alancasre133/robotic-startup-automated-arm-worker/HARDWARE.md

# Hardware — Bill of Materials

Everything needed to reproduce the robot car, plus the planned camera and arm
add-ons. Prices are rough estimates (Mexico, 2026, MercadoLibre/Amazon) and will
vary — use them for budgeting, not exact quotes.

## Wiring overview

Wiring overview

If the diagram doesn't render inline, open [docs/wiring-overview.svg](docs/wiring-overview.svg) directly.

## Pi 3 GPIO pinout reference

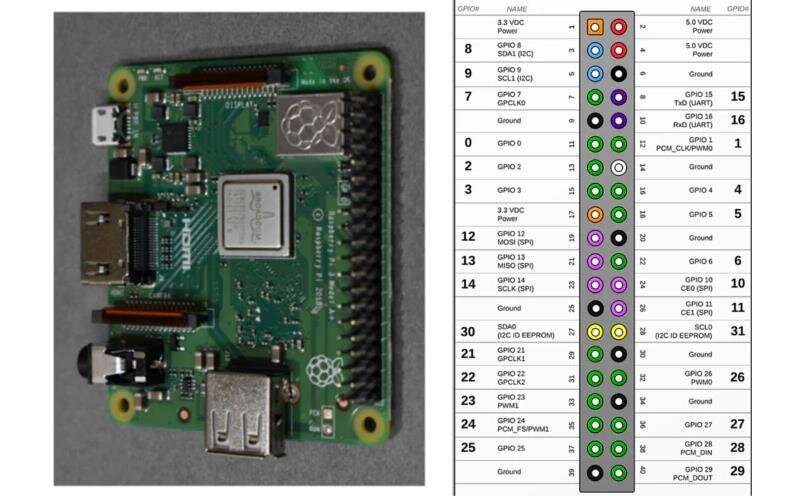
[picture p1: docs/pi3-pinout.png]
Raspberry Pi 3 GPIO pinout


Reference for the physical-pin numbers used throughout this doc (the "small
number" column = physical pin position 1–40, matching what's used here — not
the board's silkscreen GPIO# labels).

---

## Core build (the driving car)

| # | Component | Qty | What it's for | Approx. (MXN) |
|---|---|-----|---|---|
| 1 | Raspberry Pi 3 (Model A+, 3B, or 3B+) | 1 | The brain — runs the control code | 700–1000 |
| 2 | microSD card, 16 GB+ (Class 10/A1) | 1 | Operating system (Raspberry Pi OS Lite, Trixie) | 120–200 |
| 3 | USB power bank, 5V / 2A+ — bought: [Redmi 20000mAh 18W Fast Charge Power Bank](https://www.mercadolibre.com.mx/20000mah-redmi-18w-fast-charge-power-bank-black/p/MLM21029066) | 1 | Powers the Pi (kept separate from motor power) | 200–450 |
| 4 | 4WD robot car chassis kit (4× TT gear motors + wheels) | 1 | Frame + drivetrain. Replaced the original 2WD/caster chassis — the arm's weight was too much for two driven wheels | 150–400 |
| 5 | **BTS7960 (IBT-2) H-bridge, 43A** | **2** | Drive motors — one board per side, that side's two motors paralleled on it. Replaced the single L9110S, which overheated at ~3× its channel rating with 4 motors | 80–140 ea |
| 6 | 6V NiMH battery pack (2200 mAh) | 1 | Drive-motor power to the BTS7960 B+/B− (the **same kind** of pack as the servo supply). Fused at 7.5A in the B+ line | ~280 |
| 7 | Dupont jumper wires (M–F & F–F, 40+) + thick wire for B+/B− | 1 set | Pi GPIO ↔ drivers, battery joins | 80–120 |

> The chassis kit (#4) came with TT gearmotors, but the drive now runs **4×
> JGA25-370 6V 60 RPM metal gearmotors** (~10× the torque) — installed on 25 mm
> clamp brackets with 4 mm-bore brass hex coples into 65 mm hex wheels. See the
> Drive upgrade note in the README. They draw more current than the TTs, so a
> weak battery is the first thing to check if the drive is sluggish.
>
> ✅ **4WD drive is 2× BTS7960 now.** Each board drives one side's two
> paralleled TT motors from a 6V NiMH pack (43A rating — no overcurrent
> sag, unlike the old L9110S). `gpiozero`'s `Motor(forward, backward)` drives
> each board's RPWM/LPWM directly; R_EN + L_EN are tied to 3.3V (always
> enabled). Polarity note: front/rear motors are mounted mirrored, so on each
> board one motor of the pair has its two leads swapped at the M+/M− terminals
> or the pair fights itself. ⚠️ Reverse polarity on B+/B− is the one thing that
> kills a BTS7960 — double-check before connecting the pack.

## Face screen (LCD)

| # | Component | Qty | What it's for | Approx. (MXN) |
|---|---|-----|---|---|
| — | 2.0" IPS SPI LCD (**GMT020-02-7P**, ST7789V, 240×320) | 1 | MELVINN's animated face — expressions, text, and video playback | 80–150 |

> Backlight is hardwired to VCC (no BLK pin), so it glows whenever powered.
> ⚠️ The Pimoroni `st7789` pip library does **not** initialize this panel —
> the face runs on the in-repo raw driver
> [`robot_code/tests/st7789_raw.py`](robot_code/tests/st7789_raw.py). Wiring is
> in the quick reference below.

## Optional — camera (vision)

| # | Component | Qty | What it's for | Approx. (MXN) |
|---|---|-----|---|---|
| 8 | Arducam 8MP IMX219 camera module — bought: [B09V576TFN](https://www.amazon.com.mx/dp/B09V576TFN), 20"/500mm flex cable | 1 | Live video / vision on the Pi | 260–555 |

> Confirmed working on Trixie. Match the ribbon cable to the Pi 3 (15-pin,
> standard CSI).

## Robotic arm — working ✅

| # | Component | Qty | What it's for | Approx. (MXN) |
|---|---|-----|---|---|
| 9 | 6-DOF robotic arm kit (6× MG996R servos) — bought: [MLM2080598029](https://www.mercadolibre.com.mx/brazo-robotico-de-6-grados-dof-de-libertad-servomotor/p/MLM2080598029) | 1 | The arm itself | ~775 |
| 10 | PCA9685 16-channel servo driver — bought: [MLM2040047104](https://www.mercadolibre.com.mx/pca9685-modulo-pwm-16-canales-12-bits-i2c/p/MLM2040047104) | 1 | Drives the servos over I²C (the Pi has only 2 hardware PWM pins) | 60–100 |
| 11 | 6V 2200 mAh NiMH battery pack — bought: **Blomiky 2-pack, SM-2P plug + USB charging cable** | 1 (or 2-pack) | Servo power (5–6V). MG996R are current-hungry — never run off the Pi | ~560 (2-pack) |
| 12 | SM-2P connector pair (pigtail) — bought: **yueton 10-pair SM-2P male/female** | 1 | Adapts the battery's SM plug to the PCA9685 screw terminal without cutting it | ~100 |
| — | Raspberry Pi Pico *(alternative)* — bought: [Pico RP2040 Dual Core, USB-C + cable](https://www.mercadolibre.com.mx/tarjeta-raspberry-pi-pico-rp2040-dual-core-tipo-c-cable/p/MLM2055242423) | 1 | Can generate the servo PWM instead of the PCA9685 — see [docs/pico-setup.md](docs/pico-setup.md) | 120–180 |

> **Servo power:** a 6V NiMH pack connects **straight to the PCA9685 V+** (no
> regulator — 6V is in the MG996R range). **Don't cut the battery's SM plug** (the
> USB charger uses it); wire an **SM-2P pigtail** into the PCA9685 screw terminal
> instead — **red → V+, black → GND**. A small AA NiMH pack is fine for testing /
> light moves; for strong, sustained 6-servo motion, step up to a **2S LiPo + a
> 5–6V UBEC (5A+)**.
>
> Pi → PCA9685 (I²C), physical pin numbers: `pin 1 (3.3V)→VCC`, `pin 20 (GND)→GND`,
> `pin 3 (SDA)→SDA`, `pin 5 (SCL)→SCL`.
> Servos plug onto channels 0–5, in order: **base, shoulder, elbow, wrist,
> wrist_rotate, gripper** (`ARM_JOINTS` in `robot_code/tests/assistant.py`) — this
> order was confirmed empirically with `arm_jog_test.py` on the rebuilt arm
> (don't assume it from the kit's mechanical layout; it depends purely on
> which wire is plugged into which PCA9685 channel).
>
> **Confirmed working:** all 6 joints — including `wrist_rotate` (channel 4) —
> move correctly via [`robot_code/tests/arm_test.py`](robot_code/tests/arm_test.py)
> and [`robot_code/tests/arm_jog_test.py`](robot_code/tests/arm_jog_test.py).
> (One early gripper wiring issue turned out to be a loose connector, not a
> code or channel problem.) `robot_move_arm()` in `assistant.py` drives the
> same PCA9685 code path, so voice/typed commands like *"move the shoulder to
> 45"* work end to end.

## Voice assistant (audio) — working ✅

| # | Component | Qty | What it's for | Approx. (MXN) |
|---|---|-----|---|---|
| 13 | USB conference speakerphone (mic + speaker) — bought: [Techwolf Omnidirectional USB Desktop Microphone + Speaker](https://www.mercadolibre.com.mx/microfono-de-escritorio-omnidireccional-usb-techwolf-con-altavoz-para-conferencias-y-videollamadas-en-pc/p/MLM59321964) | 1 | Voice in **and** out over one USB plug | ~470 |
| 14 | USB hub — bought: [Jeeyee 4-Port USB 3.0 Hub, 5Gbps](https://www.mercadolibre.com.mx/jeeyee-puertos-usb-hub-usb-30-5gbps-4-puertos-alta-velocidad-con-proteccion-de-sobrecarga-para-laptop-pc-color-gris/p/MLM36222600) | 1 | The Pi 3A+ has one USB port — the hub runs the speakerphone + Pico together | ~120 |

> **We chose USB audio over the I²S kit.** The INMP441 + MAX98357 boards need
> their headers **soldered** and would collide with Motor A on GPIO20. A USB
> speakerphone is plug-and-play (USB-audio-class → works on the Pi), needs no
> soldering, and touches no GPIO. Confirm the speakerphone's cable ends in
> **USB-A** (or add a USB-C→USB-A adapter). The I²S kit is set aside for later.
>
> **Confirmed working:** the BY `Y02` enumerates as ALSA **card 1** (`plughw:1,0`)
> for both mic and speaker; record + playback tested. Setup / test commands are in
> [docs/voice-assistant.md](docs/voice-assistant.md).

> **USB wiring:** the Pi 3A+ has only **one USB port**, so everything else is
> USB, not GPIO:
> - Power bank **USB-A out** → Pi's **micro-USB power in** (a separate port from
>   the data USB port — this only powers the Pi, no data).
> - Pi's **USB-A port** → **USB hub** (data).
> - USB hub → **speakerphone** + **Pico** (both plugged into the hub, not
>   directly into the Pi).
>
> No soldering, no GPIO pins used by any of these four. See
> [docs/pico-setup.md](docs/pico-setup.md) for getting the Pico talking to the Pi.

## Obstacle sensing (ultrasonic) — working ✅

| # | Component | Qty | What it's for | Approx. (MXN) |
|---|---|-----|---|---|
| 15 | HC-SR04 ultrasonic distance sensor | 1 | Sonar: measure distance; stop / turn before hitting things | 30–60 |
| 16 | 1 kΩ + 2 kΩ resistors — from the **REXQualis 650-pc / 22-value 1/4W kit** (has 1 kΩ ×50 and 2 kΩ ×25) **or** a logic level shifter | 1 each | Drop the 5 V **Echo** pin to 3.3 V so it's safe for the Pi | ~99 (whole kit) |

> ⚠️ **Protect the Pi:** the HC-SR04's **Echo** pin outputs **5 V**, but Pi GPIO
> tolerates only **3.3 V**. Put a voltage divider on Echo (`Echo →1 kΩ→ GPIO`, then
> `GPIO →2 kΩ→ GND`) — or use an **HC-SR04*P*** / 3.3 V board and skip it.
>
> **Confirmed wiring** (physical Pi pin numbers): `VCC → pin 2` (5V), `GND →
> pin 34`, `Trig → pin 33` (GPIO13 BCM), `Echo → pin 35` (GPIO19 BCM) — with
> the divider's 1 kΩ leg between Echo and pin 35, and its 2 kΩ leg from pin 35
> down to `GND → pin 39`. Avoid the motor pins (16, 20, 27, 22 — BCM).
>
> **Confirmed working:** [`robot_code/tests/obstacle_avoid.py`](robot_code/tests/obstacle_avoid.py)
> reads distance with `gpiozero.DistanceSensor(echo=19, trigger=13)` and stops +
> turns the robot when something is closer than 25 cm.

## Software / accounts

- **Anthropic API key** *(optional)* — only for the smart Claude brain in
  `robot_code/tests/assistant.py`. The robot runs fully **offline and free** without it.
  See [docs/voice-assistant.md](docs/voice-assistant.md).

---

## Tools

- Small flat screwdriver (for the L9110S screw terminals)
- Electrical tape (to join bare battery wires to jumpers)
- A computer with [Raspberry Pi Imager](https://www.raspberrypi.com/software/) (flash the SD card)
- *(Optional)* soldering iron — only needed for add-ons like a WS2812B LED strip

## Wiring quick reference

Pi GPIO → 2× BTS7960 (one board per side; reuses the freed-up L9110S pins):

| Board | RPWM | LPWM | R_EN + L_EN | VCC | GND |
|---|---|---|---|-----|-----|
| **Left**  | GPIO16 (pin 36) | GPIO20 (pin 38) | Pi 3.3V | Pi 3.3V | Pi GND |
| **Right** | GPIO27 (pin 13) | GPIO22 (pin 15) | Pi 3.3V | Pi 3.3V | Pi GND |

Each board's **B+/B−** takes the 6V NiMH drive pack (**B+ through the 7.5A
fuse**, thick wire); each board's **M+/M−** drives that side's two paralleled
TT motors. R_EN + L_EN tied to 3.3V keeps both boards always enabled. If a
whole side runs backwards, swap that board's RPWM/LPWM (or its M+/M−). The Pi
is powered separately by the USB power bank. Bring-up + test:
[`robot_code/tests/bts7960_test.py`](robot_code/tests/bts7960_test.py).

Pi → face screen (**GMT020-02-7P / ST7789V**, SPI0). Enable SPI once with
`sudo raspi-config nonint do_spi 0` + reboot:

| Screen pin | Pi pin | GPIO / to |
|---|---|---|
| GND | 25 | ground |
| VCC | — | shared **3.3V junction** (pins 1/17 are taken) ⚠️ never 5V |
| SCL | 23 | GPIO11 |
| SDA | 19 | GPIO10 |
| RST | 22 | GPIO25 |
| DC  | 18 | GPIO24 |
| CS  | 24 | GPIO8 (CE0) |

Runs on [`robot_code/tests/st7789_raw.py`](robot_code/tests/st7789_raw.py);
tests: `face_test.py`, `face_styles.py`, `melvinn_hello.py`.

Pi → PCA9685 (physical pin numbers, I²C):

| PCA9685 pin | Pi pin | Function |
|---|---|---|
| VCC | 1 | 3.3V logic power |
| GND | 20 | Ground |
| SDA | 3  | I²C data |
| SCL | 5  | I²C clock |
| V+  | — | 6V servo power, from the NiMH pack — **not** the Pi |

Servo channels 0–5 (`ARM_JOINTS` order): `base, shoulder, elbow, wrist,
wrist_rotate, gripper`.

Pi → HC-SR04 (physical pin numbers):

| HC-SR04 pin | Pi pin | Notes |
|---|---|---|
| VCC  | 2  | 5V |
| GND  | 34 | |
| Trig | 33 | GPIO13 (BCM) |
| Echo | 35 | GPIO19 (BCM) — **through the 1kΩ/2kΩ voltage divider**, not direct: `Echo -> 1kΩ resistor -> (M-F jumper to pin 35) -> 2kΩ resistor -> (M-F jumper to pin 39, GND)` |

USB topology (Pi 3A+ has one USB-A data port + one micro-USB power port):

```
power bank --(USB-A -> micro-USB)--> Pi power in
Pi USB-A port --(data)--> USB hub --> speakerphone
                                   --> Pico
```

See [`robot_code/tests/motor_test.py`](robot_code/tests/motor_test.py) for the matching code,
and run [`setup.sh`](setup.sh) once to install dependencies.
