alancasre133/robotic-startup-automated-arm-worker/config/config.txt

# Known-good /boot/firmware/config.txt from the working Raspberry Pi 3 Model A+
# (Raspberry Pi OS Trixie). Snapshot reference — after a reflash, the relevant
# changes from the stock file are:
#   - camera_auto_detect=0
#   - dtoverlay=imx219            (IMX219 camera, in the [all] section)
#   - gpu_mem=128                 (in the [all] section)
#   - # dtoverlay=ov5647          (the old clone overlay, left disabled)
# The [cm4]/[cm5]/[pi5] sections are stock template blocks and do NOT apply to a
# Pi 3A+ — leave them as-is. See README.md "Camera (IMX219)" for the apply steps.
# ---------------------------------------------------------------------------

# For more options and information see
# http://rptl.io/configtxt
# Some settings may impact device functionality. See link above for details

# Uncomment some or all of these to enable the optional hardware interfaces
dtparam=i2c_arm=on
#dtparam=i2s=on
#dtparam=spi=on

# Enable audio (loads snd_bcm2835)
dtparam=audio=on

# Additional overlays and parameters are documented
# /boot/firmware/overlays/README

# Automatically load overlays for detected cameras
camera_auto_detect=0

# Automatically load overlays for detected DSI displays
display_auto_detect=1

# Automatically load initramfs files, if found
auto_initramfs=1

# Enable DRM VC4 V3D driver
dtoverlay=vc4-kms-v3d,cma-64
# dtoverlay=ov5647
max_framebuffers=2

# Don't have the firmware create an initial video= setting in cmdline.txt.
# Use the kernel's default instead.
disable_fw_kms_setup=1

# Disable compensation for displays with overscan
disable_overscan=1

# Run as fast as firmware / board allows
arm_boost=1

[cm4]
# Enable host mode on the 2711 built-in XHCI USB controller.
# This line should be removed if the legacy DWC2 controller is required
# (e.g. for USB device mode) or if USB support is not required.
otg_mode=1

[cm5]
dtoverlay=dwc2,dr_mode=host

[pi5]
dtoverlay=nospi10

[all]
gpu_mem=128
enable_uart=1
dtoverlay=imx219
