alancasre133/robotic-startup-automated-arm-worker/robot_code/tests/arm_test.py

"""
Robot arm bring-up test — PCA9685 + servos, one joint at a time.

Verifies the PCA9685 wiring and each servo before trusting the arm to
assistant.py. Uses the SAME robot_move_arm() / ARM_JOINTS the assistant uses,
so a pass here means the assistant's arm commands will work too.

SAFETY:
  - Keep the arm free to move — nothing should block a joint's travel.
  - Power the servo battery (6V NiMH -> PCA9685 V+) BEFORE running this. The
    Pi's 3.3V VCC alone runs the PCA9685 chip but not the servos.
  - If a joint strains or grinds, Ctrl-C immediately.

One-time install (on the Pi):
    sudo raspi-config nonint do_i2c 0 && sudo reboot   # enable I2C
    pip install adafruit-circuitpython-pca9685 adafruit-circuitpython-motor adafruit-blinka
    i2cdetect -y 1                                      # confirm address 40 shows up

Run:
    python3 robot_code/tests/arm_test.py
"""

from assistant import ARM_JOINTS, ARM_CENTER_ANGLES, robot_move_arm, _ensure_arm  # reuse the real arm code


def main():
    print("Arm bring-up test — one joint at a time. Ctrl-C any time to stop.\n")
    if _ensure_arm() is None:
        print("Could not reach the PCA9685 over I2C. Check:")
        print("  - I2C enabled?  i2cdetect -y 1  should show address 40")
        print("  - Pi -> PCA9685: 3.3V->VCC, GND->GND, SDA(pin 3)->SDA, SCL(pin 5)->SCL")
        print("  - adafruit-circuitpython-pca9685 / adafruit-blinka installed?")
        return

    print("PCA9685 found. Centering all joints to their ARM_CENTER_ANGLES...")
    for joint in ARM_JOINTS:
        robot_move_arm(joint, ARM_CENTER_ANGLES[joint])
    input("\nAll joints centered — press Enter to test them one at a time.")

    for joint in ARM_JOINTS:
        center = ARM_CENTER_ANGLES[joint]
        # Sweep +/-30 degrees around THIS joint's own center, clamped to the
        # 0-180 servo range (a fixed 60/120 sweep doesn't make sense once
        # some joints center far from 90 -- e.g. shoulder centers at 180).
        low = max(0.0, center - 30)
        high = min(180.0, center + 30)
        input(f"\n-- {joint} (center {center:.0f}) -- press Enter to sweep {low:.0f} -> {high:.0f} -> {center:.0f}")
        robot_move_arm(joint, low)
        input(f"   {joint} at {low:.0f} degrees. Enter to continue -> {high:.0f}")
        robot_move_arm(joint, high)
        input(f"   {joint} at {high:.0f} degrees. Enter to continue -> back to {center:.0f} (center)")
        robot_move_arm(joint, center)
        print(f"   {joint} back at {center:.0f}. Did it move smoothly and in the right direction?")

    print("\nAll joints tested. If one moved the wrong way, or not at all, check that")
    print("servo's channel number (0-5, in ARM_JOINTS order) and connector orientation.")


if __name__ == "__main__":
    try:
        main()
    except KeyboardInterrupt:
        print("\nstopped")
