alancasre133/robotic-startup-automated-arm-worker/(commit log)

2026-06-19 Add hello.py with Hello World print statement
2026-06-30 Add motor test, setup script, and hardware docs
    - robot_code/motor_test.py: drive both motors via L9110S from Pi GPIO
    - setup.sh: one-command install of gpiozero/lgpio + camera stack
    - HARDWARE.md: bill of materials, prices, and wiring quick reference
    - docs/wiring-overview.svg: system wiring diagram
2026-06-30 Document working motors + camera, add camera test
    - README: Software Setup, Motors (L9110S), and Camera (IMX219) sections
    with wiring, test commands, and the ribbon-flip / WiFi-drop gotchas
    - setup.sh: enable the imx219 overlay; add reboot/verify steps
    - robot_code/camera_test.py: Picamera2 still capture
    [camera_test.py]
2026-06-30 Add voice assistant design, pipeline diagram, and code skeleton
    - docs/voice-assistant.md: pipeline design, STT/TTS options, model choice, setup
    - docs/voice-pipeline.svg: mic -> STT -> Claude -> speak + act -> loop
    - robot_code/assistant.py: Claude tool-use loop wired to the motors (drive),
    arm + STT/TTS stubbed for later
    - README: Voice Assistant (planned) section
2026-06-30 Add known-good config.txt snapshot
    Captured /boot/firmware/config.txt from the working Pi 3A+ so the boot config
    is reproducible after a reflash. README Software Setup links to it.
    [config.txt]
2026-06-30 Document Pico W MicroPython setup
    Add docs/pico-setup.md (flash MicroPython, verify /dev/ttyACM0, mpremote usage)
    and a README pointer.
2026-06-30 Add browser camera stream (MJPEG over WiFi)
    robot_code/camera_stream.py serves the IMX219 feed at http://<pi-ip>:8000 so the
    camera can be viewed live from a laptop/phone — no screen on the Pi needed.
2026-06-30 Add image flip to camera stream (camera mounted upside down)
    FLIP constant rotates the feed 180° via libcamera Transform; set False if the
    camera is mounted upright.
    [camera_stream.py]
2026-06-30 Add reproduction guide to README
    Top-of-README overview: what works, an ordered "build from scratch" path, and a
    repository map. Add the live camera-stream step to the Camera section.
2026-06-30 Remove software image flip from camera stream
    Image orientation comes from the physical camera/ribbon mount and is expected —
    leave the feed as the sensor delivers it. Reverts the FLIP transform.
    [camera_stream.py]
2026-07-01 Document arm power + voice audio hardware
    - Arm: PCA9685 servo driver + 6V NiMH pack (+ SM-2P pigtail); servo-power notes
    - Voice: USB speakerphone + USB hub (chose USB audio over the solder-required I2S kit)
2026-07-01 Document remote camera access (Tailscale / ngrok)
    Add docs/remote-access.md — view the camera stream from anywhere via Tailscale
    (recommended, private) or ngrok (public link), plus an optional systemd service
    to auto-start the stream. Link it from the README.
2026-07-01 Mark remote camera access as working; finalize auto-start service
    Remote streaming over Tailscale is confirmed working (viewable from a phone
    on cellular). Update the status/build-steps in the README, note the confirmed
    setup in docs/remote-access.md, harden the systemd auto-start instructions
    (heredoc + daemon-reload + status check + reboot test), and document the
    corrupted-download "Illegal instruction" gotcha and its fix.
2026-07-01 Add on-device face tracking (OpenCV) + AI vision roadmap
    robot_code/vision_track.py: captures frames, detects faces with an OpenCV Haar
    cascade, draws them on a live MJPEG stream, and optionally pulses the motors to
    keep the nearest face centered. Motor driving is off by default for safety
    (DRIVE_MOTORS flag); reuses the camera_stream.py streaming scaffolding so it's
    watchable locally or over Tailscale.
    docs/vision.md: what's feasible on the 512MB/32-bit Pi 3A+ (faces now, objects
    via TFLite slow, hands need Coral/Pi4/offload), how vision_track.py works, and
    the reflexes+Claude-brain roadmap. README updated (status, repo map, section).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
2026-07-01 Document working USB audio (mic + speaker) setup
    The USB conference speakerphone (BY Y02) is confirmed working for both mic and
    speaker — enumerates as ALSA card 1 (plughw:1,0) through the USB hub. Update
    docs/voice-assistant.md to replace the abandoned I2S (INMP441/MAX98357) plan
    with the tested USB setup: device detection, record/playback test, the
    alsamixer "silent until unmuted" gotcha, and espeak-ng TTS piped to the USB
    speaker. Mark the audio section working in HARDWARE.md and the README status +
    voice section.
2026-07-02 Add papoi.py — say "papoi" out loud when a face is detected
    Fun standalone demo: OpenCV Haar face detection on the Pi camera, and when a
    face appears it speaks "papoi" through the USB speakerphone (plughw:1,0) via
    espeak-ng, with a 5-second cooldown so it doesn't repeat every frame. No API
    key needed. Added to the README repo map.
    [papoi.py]
2026-07-02 Make assistant.py runnable: Haiku model, USB-speaker TTS, typed-command loop
    Switch MODEL to claude-haiku-4-5 (fast/cheap for a voice loop). Implement
    speak() via espeak-ng piped to aplay on plughw:1,0 (same path proven by
    papoi.py). Replace the STT-gated main loop with a typed-command loop so the
    brain is runnable end to end today (type "drive forward for 2 seconds" ->
    Claude calls the drive tool -> motors move -> spoken reply). transcribe()
    stays a documented stub; voice input (Vosk) is the next step. Setup docstring
    now uses a --system-site-packages venv so gpiozero stays importable.
    [assistant.py]
2026-07-02 Add free offline fallback brain to assistant.py
    assistant.py now has two brains with automatic fallback: the Claude API when a
    key is set and the call works, and a standard-library keyword parser
    (local_brain) otherwise — no key, no internet, no pip installs. The anthropic
    import is now optional; the Claude client is built only when the SDK + key are
    present, and any Claude call failure falls back to the offline brain. "stop"
    short-circuits both brains and acts instantly as a safety measure. Documented
    the dual-brain design + updated the build order in docs/voice-assistant.md.
    [assistant.py]
2026-07-02 Lazy motor init in assistant.py — no motor twitch on startup
    Creating gpiozero Motor objects at import time pulsed the motor pins on launch.
    Defer construction to the first actual drive command via _ensure_motors(), so
    starting the assistant never touches the pins. "stop" only stops motors that
    already exist (won't wake them), and the shutdown handler guards for the
    not-yet-created case.
    [assistant.py]
2026-07-02 Interactive papoi console + Piper TTS with espeak fallback
    assistant.py: speak() now prefers Piper (natural offline voice) at $PIPER_MODEL
    and falls back to espeak-ng, both routed to the USB speaker. Offline parser also
    understands "say <text>", a bare "turn" (defaults left), and a bare number of
    seconds.
    papoi.py: rewritten into an interactive, face-aware console. A background thread
    watches for faces and runs a configurable "face action" (default: say "papoi",
    5s cooldown), while the main thread takes typed commands — say / move (forward,
    back, left, right, turn X seconds) / stop / "when you see my face do X". Reuses
    assistant.py's brain (Claude-or-offline) and voice; a lock serializes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
2026-07-02 Docs: sync to current state (git workflow, assistant/console, Piper, HC-SR04)
    README: "What works today" now lists the talk-to-it assistant, the interactive
    face console, and the on-hand HC-SR04; new "Get the Code (git)" section (clone +
    fine-grained PAT); "Voice Assistant (planned)" rewritten as "Talk to the Robot"
    (runnable dual-brain, offline vs Claude, --system-site-packages venv, papoi
    console); build steps + repo map updated.
    HARDWARE: added the HC-SR04 ultrasonic sensor (with the 5V Echo -> 3.3V voltage-
    divider warning) and an optional-API-key note.
    voice-assistant.md: model default is now claude-haiku-4-5; venv uses
    --system-site-packages; speak() prefers Piper (PIPER_MODEL) with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
2026-07-03 Active braking so drives halt fast instead of coasting
    gpiozero stop() only cuts power, so wheels coast — very visible with the wheels
    off the ground. Add _brake() that drives both L9110S inputs high for a dynamic
    brake (0.15s) then releases, used at the end of every timed drive and by the
    "stop" command. Falls back to a plain stop if the driver devices aren't exposed
    on this gpiozero version, so it can't regress.
2026-07-03 Revert active braking — both-inputs-high left the L9110S driving
    Driving both L9110S inputs high was meant as a dynamic brake, but on this board
    it reads as "keep going" — the motor ran until program exit reset the pins. Go
    back to plain gpiozero stop() (both inputs low), which is what motor_test.py uses
    and reliably cuts power.
    [assistant.py]
2026-07-03 Fix: motors keep running after stop() — use pwm=False
    Symptom: after a timed drive the motor spun until the program exited (which
    releases the pins). Root cause: gpiozero software PWM left a residual signal on
    the pin at value 0, so stop() didn't cut the drive. Create the Motors with
    pwm=False so forward()/stop() are plain digital on/off and stop() drives a hard
    low. (motor_test.py hid this because it exits right after driving.)
    [assistant.py]
2026-07-03 Add motor_diag.py — step through raw L9110S pin states to debug non-stopping motor
    Drives the four input pins directly (OutputDevice, no PWM / no Motor class) with
    pauses so we can see exactly which pin states spin vs stop the motor, and whether
    only releasing the pins (close) stops it. Used to diagnose the "motor keeps
    running after stop()" issue.
    [motor_diag.py]
2026-07-04 Add gitignore, requirements.txt, obstacle avoidance, update setup.sh with voice/music deps
    [obstacle_avoid.py]
2026-07-04 Fix song-picker crash, turn regression, wrong-file playback; cache Vosk model; add prompt caching + history trim
    [assistant.py]
2026-07-04 HARDWARE.md: record REXQualis resistor kit as the divider parts source
2026-07-05 Wire up the arm: PCA9685 + servos, plus a step-by-step bring-up test
    assistant.py: robot_move_arm() now actually drives the PCA9685 over I2C via
    adafruit-circuitpython-pca9685/motor (board.SCL/SDA, 50Hz, 500-2500us pulse),
    lazily connecting on first use like the motors. Optional import — falls back
    to a clear "not installed" / "not connected" message if the library or
    hardware isn't there, so nothing else breaks. Moved the joint list to a single
    ARM_JOINTS constant (was a duplicate _JOINTS in the offline parser) so the
    tool schema, offline parser, and hardware code all agree on the 5 joints
    (base, shoulder, elbow, wrist, gripper) mapped to PCA9685 channels 0-4.
    arm_test.py: new bring-up s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
2026-07-05 Workaround for motor A's stuck A-1A wire: pivot instead of backward/left
    motor_diag.py showed GPIO16 (A-1A) has no effect on motor A at all — it only
    responds to A2/GPIO20 (forward vs stop) — consistent with that wire being
    loose/disconnected. That makes a.backward() unreliable, which only "backward"
    and "left" actually use ("forward", "right", "spin" never call it).
    Add MOTOR_A_A1A_STUCK (default True): substitutes a.stop() for a.backward()
    in just those two moves, turning a two-wheel spin into a one-wheel pivot on A
    -- the robot can still turn/back away, just wider/slower than normal. The
    spoken reply notes when a move was downgraded. Flip the flag to False (or
    delete the substitution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
    [assistant.py]
2026-07-05 Fix setup.sh: install python3-pip, use python3 -m pip, drop missing apt package
    Trixie has no `pip` binary on PATH by default (only apt install python3-pip
    provides one, and even then `python3 -m pip` is more reliable than a bare
    `pip` call) -- every pip install line in the script was failing with
    "pip: command not found". Add an explicit python3-pip apt install up front and
    switch all pip calls to `python3 -m pip`. Also drop `python3-sounddevice` (not
    in Trixie's repos -- "Unable to locate package") in favor of pip-installing
    `sounddevice` like the other Python deps.
2026-07-09 Docs: mark arm and obstacle sensing as working (all 5 joints tested)
    README: "What works today" now lists arm, obstacle sensing, voice input, and
    music as done (not planned); build steps 12-14 replaced with arm bring-up,
    obstacle-sensing bring-up, and voice mode; repo map gains arm_test.py,
    obstacle_avoid.py, motor_diag.py. "Talk to the Robot" section rewritten to
    match the current assistant.py (voice mode by default, --type for keyboard,
    arm/music commands, links to the bring-up scripts) -- it was still describing
    the pre-voice, pre-arm, pre-music version.
    HARDWARE.md: "Planned -- robotic arm" -> "Robotic arm -- working (all 5 joints
    pass arm_test.py)"; "On hand -- obstacle sensing" -> "wo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
2026-07-09 Document the libwtmpdb SSH-crash fix and safe power-off steps
    Add a "Troubleshooting" section: SSH accepts the password then closes
    immediately with no error in any normal log (journalctl, dmesg, PAM,
    AppArmor, systemd --user all clean). Root cause was a segfault in
    libwtmpdb0 while writing /var/log/wtmp.db, only found by running a
    one-shot `sshd -d` instance under strace on a spare port and watching
    the syscalls live -- documented as a reusable diagnostic recipe. Fix
    was `sudo apt upgrade` (15 pending updates had never been applied).
    Also documents the broader pattern: this SD card has now corrupted
    three unrelated packages (numpy/picamera2's AppArmor parse, liblcms2-2's
    dpkg metadata, and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
2026-07-09 Move bring-up/diagnostic scripts into robot_code/tests/
    robot_code/ now holds only the real, ongoing programs (assistant.py,
    camera_stream.py, papoi.py, obstacle_avoid.py, vision_track.py).
    robot_code/tests/ holds the one-off scripts used to verify wiring before
    trusting it to those programs: arm_test.py, camera_test.py, motor_test.py,
    motor_diag.py, hello.py.
    arm_test.py's sys.path insert updated to look one directory up (assistant.py
    stays in robot_code/, not tests/) -- verified it still imports correctly.
    Updated all "Run:" docstring paths in the moved files, plus every reference
    across README.md, HARDWARE.md, and setup.sh to the new robot_code/tests/...
    paths.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
    [arm_test.py, camera_test.py, motor_diag.py, motor_test.py]
2026-07-09 Fix arm: kit has 6 servos, not 5 -- add the missing wrist_rotate axis
    ARM_JOINTS was missing a 6th joint (the kit is 6-DOF: base, shoulder, elbow,
    wrist, wrist_rotate, gripper), so channel 5 was never addressable. Add
    "wrist_rotate" to ARM_JOINTS (channels 0-5 now, not 0-4) and to the move_arm
    tool schema description.
    Offline parser fix: "wrist" is a substring of "wrist_rotate", so matching
    joints in tuple order would always pick "wrist" first even when the user
    meant wrist_rotate. Now checks longer/more specific joint names first and
    accepts "wrist rotate" (spoken/typed with a space) as well as the
    underscored form.
    Docs corrected to be accurate about what's actually been tested: only 5 o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
    [arm_test.py, assistant.py]
2026-07-09 Add arm_jog_test.py -- jog each servo live with the arrow keys
    Interactive alternative to arm_test.py's scripted 60/120/90 sweep: LEFT/RIGHT
    nudges the current joint's angle by 5 degrees in real time, Enter moves to the
    next joint, 'b' goes back to the previous one, 'q' quits. Prints a summary of
    the final angle reached per joint on exit.
    Built on Python's stdlib curses module (no extra installs) so arrow-key
    escape sequences are decoded for free; curses.wrapper() restores the terminal
    cleanly even on Ctrl-C or an error. Reuses the exact same robot_move_arm() /
    ARM_JOINTS / _ensure_arm() from assistant.py as arm_test.py does, so what you
    see here is exactly what voice/typed arm commands wil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
    [arm_jog_test.py]
2026-07-09 Fix: gripper silently moved to the wrong PCA9685 channel
    Inserting "wrist_rotate" before "gripper" in ARM_JOINTS shifted gripper from
    channel 4 to channel 5 in code -- but gripper is physically wired (and was
    already tested) on channel 4. Every "move gripper" command since that commit
    was sent to channel 5 instead, which is empty/wrong, so the real gripper
    servo never moved.
    Fix: append wrist_rotate at the END of ARM_JOINTS instead of before gripper,
    so the first 5 channels keep the exact mapping that was already wired and
    tested (base=0, shoulder=1, elbow=2, wrist=3, gripper=4). wrist_rotate is
    channel 5 -- a new channel, not a reshuffle of existing ones. Updated
    HARDWARE.md's channel-orde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
    [assistant.py]
2026-07-09 Arm fully working: all 6 joints tested, including wrist_rotate
    Root cause of the earlier "gripper not moving" was a loose connector, not a
    code or channel bug -- confirmed working after reseating it. Drop the "5 of
    6" / "still to wire" caveats across README, HARDWARE.md, and
    voice-assistant.md now that all 6 joints (base, shoulder, elbow, wrist,
    gripper, wrist_rotate) have been verified via arm_test.py and
    arm_jog_test.py.
2026-07-09 Drop the WiFi pre-hashed-password fix as a required step
    Confirmed on a fresh flash: current Raspberry Pi Imager writes network-config
    with a usable password (or the underlying cloud-init issue was fixed) --
    WiFi just works without manually editing the bootfs file. Rename the section
    to "SD Card Setup" and demote the old hex-password workaround to a collapsed
    "if this happens" note for anyone on an older Imager version, rather than a
    mandatory step. Updated the other two places that referenced the old
    section title/anchor.
2026-07-10 Fix HC-SR04 pins to match the actual rebuild wiring; record exact parts bought
    The fresh rebuild wired the HC-SR04 to different GPIOs than the original
    docs/code (Trig->GPIO23/pin16, Echo->GPIO24/pin18): actual wiring is
    Trig->GPIO13/pin33, Echo->GPIO19/pin35 (via the same 1k/2k divider), GND on
    pin34, VCC on pin2. Updated obstacle_avoid.py's TRIG_PIN/ECHO_PIN constants
    and docstring, and HARDWARE.md's wiring note, to match reality instead of
    rewiring to match stale docs.
    Also recorded the exact components purchased for the arm (MercadoLibre
    listings for the arm kit and PCA9685, Blomiky NiMH pack, yueton SM-2P
    pigtails) and the PCA9685's physical GND pin (20), for full reproducibility.
    Co-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
    [obstacle_avoid.py]
2026-07-10 Don't let a broken vosk native library crash the whole module
    vosk's bundled libvosk.so can fail to load with OSError ("cannot enable
    executable stack as shared object requires") on some Debian trixie/armhf
    installs -- OSError, not ImportError, so the existing except clause let it
    propagate and crash assistant.py at import time. That broke arm_test.py and
    arm_jog_test.py too, since they only need ARM_JOINTS/robot_move_arm from
    assistant.py and never touch voice input at all. Catch OSError alongside
    ImportError so a broken/incompatible vosk install degrades to
    _VOSK_AVAILABLE = False instead of taking down everything that imports
    this module.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
    [assistant.py]
2026-07-10 Automate the vosk execstack fix in setup.sh (and document it in assistant.py)
    vosk's bundled libvosk.so needs its executable-stack ELF flag cleared to load
    on Debian trixie/armhf (OSError: "cannot enable executable stack as shared
    object requires"). setup.sh now installs `execstack` and patches whichever
    libvosk.so it actually finds (located dynamically via `python3 -c "import
    vosk..."` so it isn't tied to one Python version/install path), so a fresh
    setup.sh run on a reflashed card doesn't hit this. Also documented the manual
    fix in assistant.py's module docstring for anyone following those steps by
    hand instead of running setup.sh.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
    [assistant.py]
2026-07-10 Fix ARM_JOINTS channel order to match rebuilt arm's actual wiring
    Empirically verified via arm_jog_test.py: channel 4 is wrist_rotate
    (wrist twist), channel 5 is gripper (the claw) -- swapped from what
    was coded for the previous build. Updates the tuple, the move_arm
    tool schema description, and the matching docs in HARDWARE.md/README.md.
    [assistant.py]
2026-07-10 Add wheel_jog_test.py — interactive motor test like arm_jog_test.py
    Lets you pulse Motor A / Motor B forward and backward one at a time with
    the arrow keys and watch which wheel responds, using the same motor_a/
    motor_b objects assistant.py drives in production.
2026-07-10 Add retry logic + honest failure summary to setup.sh's apt installs
    apt install downloads everything before installing anything, so one
    flaky-WiFi mirror drop mid-download (seen on the camera stack's ~294
    packages) aborted the whole transaction with nothing installed. The
    script had no set -e, so it printed the error and kept going, ending
    in a misleading "Setup complete" even though e.g. python3-picamera2
    never got installed.
    apt_install() now retries each package group up to 3 times with a 5s
    backoff, and the final summary lists anything that still failed
    instead of unconditionally claiming success.
2026-07-10 Record the exact camera module purchased in HARDWARE.md
    Arducam 8MP IMX219, 20"/500mm flex cable, bought from Amazon MX
    (B09V576TFN) -- same product used in the confirmed-working setup.
2026-07-10 Remove references to other camera modules
    Now that the exact camera (Arducam 8MP IMX219) is documented, drop the
    generic "Camera Module v2" naming and the OV5647-clone warning -- not
    relevant to the camera actually used in this build.
2026-07-10 Move all robot_code/*.py into robot_code/tests/
    These are being reworked under new plans; consolidating everything into
    tests/ for now instead of splitting production vs. bring-up code. Updates
    all doc references (README, HARDWARE.md, docs/*.md), the systemd service
    path in docs/remote-access.md, setup.sh's post-install hints, and drops
    the now-unnecessary sys.path.insert(..) hacks in the jog/bring-up tests
    that used to reach up to robot_code/ for assistant.py (it's a sibling now).
    [arm_jog_test.py, arm_test.py, assistant.py, camera_stream.py, obstacle_avoid.py, papoi.py, vision_track.py, wheel_jog_test.py]
2026-07-10 Record exact purchase links for power bank, Pico, mic, and USB hub
    Redmi 20000mAh power bank, Raspberry Pi Pico RP2040 (USB-C), Techwolf
    USB speakerphone, and Jeeyee 4-port USB 3.0 hub -- the actual products
    used in this build.
2026-07-10 Document USB wiring/topology for power bank, hub, mic, and Pico
    These four connect purely over USB (no GPIO, no soldering): power bank
    into the Pi's micro-USB power-in, everything else fanned out through a
    hub off the Pi's single USB-A data port. Adds this to both the voice
    assistant section and the wiring quick-reference at the bottom.
2026-07-10 Add PCA9685/HC-SR04 wiring tables and update the wiring diagram
    HARDWARE.md's "Wiring quick reference" now has pin-mapping tables for
    the PCA9685 (I2C) and HC-SR04, matching the style already used for the
    L9110S. docs/wiring-overview.svg replaces the stale "Pico W + Arm
    (planned)" placeholder with the actual PCA9685 + 6-DOF arm setup that's
    confirmed working, including the I2C link from the Pi and the NiMH
    servo battery.
2026-07-10 Add the HC-SR04 distance sensor to the wiring diagram
    The pin table was already in HARDWARE.md but the diagram itself never
    got the sensor box -- adds it below the arm, wired from the Pi (routed
    around the arm box) with Trig/Echo + divider labeled, plus a legend
    entry for the new sensor color.
2026-07-10 Add Pi 3 GPIO pinout reference image to HARDWARE.md
    This is the pinout chart used to cross-check all the physical-pin
    wiring notes throughout this doc (HC-SR04, PCA9685, L9110S, etc).
2026-07-10 Add exact jumper/resistor chain for the Echo divider to HARDWARE.md
    Records the physical assembly: Echo -> 1kOhm resistor -> M-F jumper to
    pin 35 -> 2kOhm resistor -> M-F jumper to pin 39 (GND).
2026-07-10 Fix vosk auto-setup: use patchelf (not execstack) + verify the model download
    Two real, on-device-confirmed failures in an unattended 'bash setup.sh':
    1. execstack isn't packaged for Trixie at all (apt install execstack ->
    "Unable to locate package"), so the executable-stack patch never ran
    and every voice-mode run hit "cannot enable executable stack". Switched
    to patchelf --clear-execstack, which does exist in Trixie's repos, and
    verify the fix by actually importing vosk afterward instead of trusting
    the exit code.
    2. The Vosk model download (wget | unzip | mv) had no error handling, so a
    flaky-WiFi drop mid-download silently left ~/vosk-model missing while
    the script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
2026-07-10 Fix mic capture: use arecord instead of sounddevice/PortAudio
    Voice mode failed at runtime with:
    PortAudio: Invalid sample rate [PaErrorCode -9997]
    PortAudio's raw ALSA "default"/"sysdefault" device wouldn't negotiate the
    16kHz Vosk needs. Switched transcribe() to pipe from
    `arecord -D plughw:1,0 -r 16000` instead -- the exact command already
    confirmed working in docs/voice-assistant.md, and consistent with how
    playback already goes through aplay/mpg123 subprocesses in this file.
    plughw does the sample-rate conversion; the raw default device doesn't.
    Drops the now-unused sounddevice dependency from setup.sh, the assistant.py
    setup docstring, and README.md. Also swaps the docstring's stale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
    [assistant.py]
2026-07-10 Auto-unmute the USB speakerphone volume in setup.sh
    Confirmed on-device: the Techwolf/BY Y02's PCM Playback Volume defaults
    to 0 on a fresh setup. This looked exactly like a dead/silent mic during
    debugging (arecord+aplay round-trip produced no audible sound), but the
    mic capture itself was fine the whole time -- only the speaker was muted.
    setup.sh now finds the USB Audio capture card, unmutes + boosts both
    playback and mic volume, and saves with alsactl store so it survives a
    reboot (ALSA mixer state resets by default otherwise).
2026-07-10 Add arm_sequence.py: record and replay arm pose sequences
    Record mode reuses arm_jog_test.py's jog UI (arrow keys + Enter/b to
    switch joints), plus SPACE to capture the current full pose as a step
    and u to undo the last one. Saves the sequence as JSON under
    robot_code/tests/arm_sequences/<name>.json.
    Play mode loads a saved sequence and replays it step by step through
    robot_move_arm(), the same function voice/typed commands use.
    Usage:
    python3 arm_sequence.py record <name>
    python3 arm_sequence.py play <name>
    python3 arm_sequence.py list
2026-07-10 Add wheel recording to arm_sequence.py, switchable with TAB
    One sequence can now interleave arm poses and wheel moves. TAB toggles
    between ARM mode (unchanged: jog + SPACE to capture a pose) and WHEEL
    mode (new: arrow keys drive immediately via robot_drive() and are
    captured automatically -- UP/DOWN forward/backward, LEFT/RIGHT turn,
    SPACE spin, x explicit stop).
    Step schema is now tagged: {"type": "arm", "pose": {...}} or
    {"type": "drive", "direction": ..., "seconds": ...}. play() and
    list_sequences() handle both step types; list_sequences() reports the
    arm/drive breakdown per sequence.
2026-07-11 Install ffmpeg in setup.sh -- yt-dlp needs it to convert to mp3
    Confirmed on-device: yt-dlp downloaded the audio fine but failed at the
    very end with "Postprocessing: ffprobe and ffmpeg not found", leaving a
    .webm file in ~/music instead of the expected .mp3.
2026-07-11 Make "download X" offer 3 options with a repeat-to-hear-again picker
    download_song() previously just grabbed yt-dlp's single top search result
    with no choice involved. It now reuses the same search-3/pick-one flow
    play_song() already had for songs not in the local library.
    _pick_from_voice() now owns announcing the options itself (play_song had
    been duplicating that before calling it) and loops up to 3 times: saying
    "repeat"/"again" re-announces the options instead of the old behavior of
    silently guessing or defaulting to option 1 on the first unclear answer.
2026-07-11 Surface mpg123 playback failures instead of always saying "Playing..."
    _play_file() suppressed mpg123's stderr entirely, so "play a song" always
    reported success even if mpg123 crashed immediately (bad device, bad
    file, etc.) -- silent failure masquerading as a working response, which
    is what's being debugged now (assistant.py said "Playing X" but nothing
    was audible, while running mpg123 manually with the same device worked).
    Now waits 300ms after spawning and checks poll(): if mpg123 already
    exited, reports its real exit code and stderr instead of "Playing...".
    [assistant.py]
2026-07-11 Widen the mpg123 crash-detection window from 300ms to 1.5s
    Confirmed on-device: mpg123 was exiting in under a second (not the
    expected multi-minute playback), but the previous 300ms check missed it
    -- "play a song" still reported success with nothing audible. 1.5s gives
    enough margin to catch a fast-but-not-instant crash and surface the real
    error instead.
    [assistant.py]
2026-07-11 Stop TTS from colliding with mpg123 over the exclusive ALSA device
    Confirmed on-device: "play a song" printed "Playing X" then immediately
    hit "aplay: audio open error: Device or resource busy" -- speak()
    announcing the "Playing X" confirmation via aplay was fighting mpg123
    for the same plughw device (a raw hw passthrough, not software-mixed;
    only one process can hold it at a time).
    _play_file() now prints that confirmation instead of speaking it, and
    returns "" on success so the caller doesn't speak it either. main()
    skips speak() on an empty reply. Playback failures still return a
    message and DO get spoken, since mpg123 has already exited by then.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
    [assistant.py]
2026-07-11 Add a FLIP_180 config flag to correct the upside-down camera mount
    The IMX219 is physically mounted upside down on this robot's chassis, so
    every camera-using script now applies a 180-degree transform (hflip +
    vflip) via libcamera.Transform. Added consistently to camera_stream.py,
    camera_test.py, vision_track.py, and papoi.py -- all four configure
    Picamera2 independently. FLIP_180 = True is the default; set to False if
    the mount changes.
    [camera_stream.py, camera_test.py, papoi.py, vision_track.py]
2026-07-12 Add rock-start to break static friction on heavy chassis + standalone rock_test
2026-07-12 Add per-joint center angles for the arm (shoulder/elbow at 45, not 90)
    Centering all 6 joints at 90 (the servo midpoint) was clashing the arm
    into the chassis on this build -- confirmed on-device. New
    ARM_CENTER_ANGLES dict in assistant.py sets shoulder=45, elbow=45, and
    leaves base/wrist/wrist_rotate/gripper at the 90 default.
    arm_jog_test.py and arm_sequence.py both now start each joint at its
    center angle instead of a hardcoded START_ANGLE=90, and gained a 'c' key
    to recenter just the current joint mid-session (useful after jogging it
    away and wanting to snap back without manual nudging).
    [arm_jog_test.py, arm_sequence.py, assistant.py]
2026-07-12 Set shoulder center angle to 180 (confirmed clear-of-chassis spot)
    Was 45; on-device testing found 180 is the actual clean spot for this
    joint, not 45.
2026-07-12 Use ARM_CENTER_ANGLES consistently in arm_test.py and voice/typed commands
    Two more spots were still hardcoded to 90 degrees, missed when
    ARM_CENTER_ANGLES was introduced:
    - arm_test.py's "center all joints" step and each joint's sweep test's
    "back to center" step -- for shoulder (center 180) this would have
    driven it into the chassis exactly like the bug we just fixed
    elsewhere. Sweep range is now +/-30 around each joint's own center,
    clamped to 0-180, instead of a fixed 60/120 that assumed center=90.
    - local_brain()'s fallback when "move the shoulder" is said with no
    angle -- was defaulting to 90 regardless of joint.
    [arm_test.py, assistant.py]
2026-07-12 Add rock-start to obstacle_avoid.py, matching assistant.py's ROCK_START
    Same jab-before-drive approach (3 jabs, 0.12s on / 0.06s off) needed
    once the arm's added weight made cold starts unreliable elsewhere.
    Applied only on the stopped->moving transition (tracked via a `moving`
    flag) rather than every 50ms poll, so it doesn't re-jab while already
    driving steadily. turn_right() always rocks since a turn is always a
    start-from-stop.
    [obstacle_avoid.py]
2026-07-12 Auto-repeat rock-start jabbing instead of requiring manual relaunches
    Confirmed on-device: one round of jabbing doesn't always break the bot
    loose at its current weight -- it sometimes took several manual re-runs
    of rock_test.py before it moved. Added ROCK_ROUNDS (3) to assistant.py's
    robot_drive() and obstacle_avoid.py's _start(), and a matching ROUNDS
    loop in rock_test.py, so each one now automatically retries the jab
    sequence a few times (with a brief settle pause between rounds) before
    committing to steady drive, instead of stopping after a single attempt.
    [assistant.py, obstacle_avoid.py, rock_test.py]
2026-07-12 Add ultrasonic approach-and-grab: arm poses, gripper, distance sensing, grab strategy in Claude brain + offline fallback
2026-07-12 grab_sequence: don't back up when too close (bot can't reverse yet) — grab from in-reach
    [assistant.py]
2026-07-12 Camera-guided grab: color-blob object finding, smooth 1deg arm motion, ultrasonic-vision distance calibration
2026-07-12 Use learned camera distance estimate in grab approach when ultrasonic can't see the object
2026-07-12 Stage 1: ORB object enrollment + recognition (show-and-learn specific objects) + enroll/recognize test tools
2026-07-14 Write calibrated ARM_POSES + gripper angles from on-device jogging
2026-07-14 grab_sequence: center the arm first (same neutral as arm_jog_test) before ready pose
2026-07-14 Ultrasonic: median-of-3 to kill spikes; bump ARM_REACH_CM to 22 to match object distance
2026-07-14 look_for_object: sample 4 frames, keep best hit — ride over single-frame dropouts
2026-07-14 grab_sequence: verify the grab with the camera and retry up to 3 times
    After the lift, compare the blob's size to what it was just before the
    grab. A comparably-sized blob still in view means the object never left
    the table -> reopen, reset to ready, and try again (up to GRAB_ATTEMPTS).
    Size comparison, not mere visibility, so an object dangling from the
    gripper in front of the camera doesn't read as a miss.
    [assistant.py]
2026-07-14 Give MELVINN switchable voices
    Seven named presets (melvinn/robot/deep/chipmunk/female/whisper/spanish)
    built on espeak-ng voice+pitch+speed — all offline, nothing to install.
    set_voice() demos the voice as it switches; exposed as a Claude tool and
    an offline keyword ('use your robot voice'). Piper still handles the
    default voice and picks up ~/piper/<name>.onnx per-voice models if you
    add them. MELVINN_VOICE env var sets the startup voice.
2026-07-14 Multitasking: background actions, a voice kill-switch, and a grab_all task loop
    - Long actions now run in a worker thread (start_action) so the main
    loop keeps listening while MELVINN moves.
    - Saying 'stop' mid-action sets _stop_event; grab_sequence checks it
    between steps and bails out cleanly. 'Stop' is now a real kill-switch,
    not just a wheel stop.
    - One action at a time: new motion requests while busy get 'I'm busy
    <doing X>. Say stop to interrupt me.'
    - grab_all(color): find -> grab (verified, with retries) -> pivot aside
    -> drop -> pivot back -> repeat until a full sweep finds nothing.
    - Both brains wired: offline keywords ('grab all the yellow ones') and
    new Claude tools g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
2026-07-14 Voices: discover downloaded piper models, add list_voices
    set_voice now accepts any ~/piper/<name>.onnx model as well as the
    espeak presets. list_voices reports natural voices first, then the
    classic robot presets — wired as a Claude tool and into the offline
    'voice' keyword.
2026-07-14 Give MELVINN silly voices + animal sounds
    No real dog TTS exists, so: four character voice presets (puppy, growl,
    alien, giant) built from espeak pitch/speed, plus play_sound for actual
    noises (bark/woof/growl/howl/meow). Wired into both brains — offline
    keywords ('bark', 'make a dog sound') and a play_sound Claude tool.
    [assistant.py]
2026-07-14 Voice EFFECTS layer: SoX post-processing over any voice
    Deep-research payoff. Instead of only espeak pitch tricks, route the
    finished TTS audio (piper OR espeak) through SoX effect chains, so a
    natural voice can sound like a robot, Dalek, monster, ghost, underwater,
    telephone, cave, space, giant, chipmunk, or drunk — effects STACK on top
    of whichever voice is selected. Refactored _say_piper/_say_espeak to both
    write a wav and share _play_wav(), which applies the active effect via
    sox before aplay (graceful no-op if sox missing). set_effect wired into
    both brains + a Claude tool; list_voices now lists effects; sox added to
    setup.sh's audio tools.
    [assistant.py]
2026-07-14 Add Kokoro TTS backend (high-quality neural voice) via local HTTP server
    onnxruntime has no 32-bit ARM build, so instead of fighting it on the
    Pi 3, speak() calls a Kokoro server (kokoro-fastapi OpenAI-compatible
    endpoint) set via KOKORO_URL -- run it on the Mac, Pi calls it over
    Tailscale. Engine order is now Kokoro -> Piper -> espeak, each falling
    through if it can't speak, so it stays fully working offline. Kokoro
    voice names (af_heart, am_michael, ...) route to the server and show up
    in list_voices / set_voice when KOKORO_URL is configured.
2026-07-15 Neural voice: sherpa-onnx Kokoro as MELVINN's default TTS
    sherpa-onnx installs on the 32-bit Pi 3 (ships its own armv7l wheel +
    bundled runtime) where kokoro-onnx couldn't. Wire it in as the top TTS
    backend: speak() now tries sherpa-onnx Kokoro first (handles the default
    'melvinn' voice + 11 named neural speakers), then falls through to
    kokoro-onnx -> Piper -> espeak. Model dir ~/kokoro-en-v0_19. Effects
    still apply (shared _play_wav). MELVINN now sounds neural by default,
    fully offline, on a Pi 3.
2026-07-15 Fix startup hang: sherpa-onnx neural voice is opt-in, not default
    The Kokoro model needs ~900MB and swap-thrashed the 1GB Pi 3 on the very
    first speak() at startup (unkillable). Default reverts to Piper (fast,
    light); sherpa only loads when a sherpa speaker is explicitly selected.
    [assistant.py]
2026-07-15 Add distance_monitor.py: live ultrasonic readout with a bar for calibration
    Prints the median-filtered distance a few times a second so you can
    watch an object move and pick ARM_REACH_CM. Silences gpiozero's no-echo
    warning spam and prints a clean 'no echo' instead.
2026-07-15 distance_calibrate: accumulate samples across runs, warn on colour
    Re-running now merges with the previous run's samples for the same
    colour (instead of overwriting), so 'run again to refine' actually
    works. Added a hint to check the colour arg when too few samples land --
    the common mistake is calibrating 'red' (default) for a yellow object.
    [distance_calibrate.py]
2026-07-15 grab_test: live distance printout throughout the run, incl. arm state
    Background daemon thread prints the distance a few times a second for the
    whole grab -- so you can watch how far the object is while the arm
    reaches and grips. Made distance_ahead() lock-guarded so the monitor
    thread and the grab loop never pulse the HC-SR04 simultaneously (which
    would corrupt both readings).
2026-07-16 Voice-run the test scripts: 'Melvinn, run the grab test with yellow'
    run_script launches a WHITELISTED test script (grab test, distance
    monitor, vision test, arm test, ...) as a background action -- 'stop'
    kills it, output tail is spoken when it finishes. Releases our gpiozero/
    camera handles first so the child can claim the pins (they re-init
    lazily afterwards). Interactive scripts (arm_jog, enroll, papoi) are
    deliberately excluded -- they need a keyboard. Wired into both brains
    and added the new words to the STT grammar so Vosk can actually hear
    'run the grab test'.
2026-07-17 Document the 4WD chassis swap and paralleled-motor wiring
    The 2WD chassis + caster was replaced with a 4WD chassis (4x TT motors)
    because the arm's weight was too much for two driven wheels. The two new
    motors are paralleled onto the existing L9110S channels (front+rear per
    side), which exceeds the channel's ~800mA rating at breakaway -- caveat
    recorded, with the second-L9110S-fed-from-spare-PCA9685-channels plan as
    the proper fix, plus the mirrored-mount polarity gotcha. README's drive
    bullet downgraded to in-progress while starts are tuned.
2026-07-17 motor_test.py: add a both-channels-at-full-power phase (4WD max load)
    Two changes for the 4WD paralleled-motor setup:
    - pwm=False on both Motor objects, matching every other script -- plain
    digital HIGH to the L9110S means full battery voltage to the motors,
    nothing throttling them. (forward() was already full duty, but this
    makes it explicit and consistent.)
    - New phase 3 runs BOTH channels forward simultaneously for 3s: the
    maximum current the battery + driver will ever see. The solo phases
    stay for per-pair direction checking (paralleled front/rear wheels
    must agree); a visible slowdown in phase 3 vs the solo runs is the
    battery sagging under combined draw.
    Co-Authored-By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
    [motor_test.py]
2026-07-18 Add a "rocky" voice effect (Project Hail Mary's Eridian)
    Rocky doesn't speak in a timbre so much as in CHORDS -- several notes at
    once, heard through the wall of his high-pressure tunnel. Three detuned
    chorus voices stack harmonics over the speech to fake that, a -150 cent
    pitch drop gives it body, and reverb puts it back in the tunnel.
    Untested on-device (no sox on the dev machine to validate the chain).
    _play_wav() already falls through to the dry wav if sox errors, so a bad
    chain degrades to a normal voice rather than breaking speech.
    [assistant.py]
2026-07-18 Add melvinn_description: URDF model of MELVINN for ROS 2
    Models the robot as actually built -- 4WD chassis, 6-DOF MG996R arm,
    HC-SR04, and the IMX219 on the wrist. ROS 2 Jazzy runs on the PC (WSL2),
    not the Pi: there are no armhf binaries and the 3A+ has 512MB, so
    nothing here gets installed on the robot.
    The six arm joints are named exactly as ARM_JOINTS in assistant.py, and
    zero radians means each joint's ARM_CENTER_ANGLES value -- so a
    /joint_states message from the robot will map onto this model with no
    translation layer. That's also why some limits are asymmetric: the
    shoulder centres at 180 and the elbow at 45 because the arm fouls the
    chassis elsewhere.
    Verified: xacro expands, chec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
    [melvinn.urdf.xacro]
2026-07-18 Add melvinn_sim: drive the model from /cmd_vel, and require CycloneDDS
    fake_drive integrates a unicycle model from /cmd_vel, broadcasting
    odom->base_footprint and spinning the wheel joints, so MELVINN drives
    across the grid in RViz. Verified numerically: 0.2 m/s for ~3s moved him
    0.64m along x; 0.5 rad/s for ~2s turned him 54 degrees.
    Kinematics only -- no mass, friction, or torque, so the real robot's
    actual problem (heavy arm, current-starved motors needing rock-start)
    doesn't exist here. It exercises the interface, which is what Nav2 and a
    real-robot bridge will speak. Physics would mean Gazebo.
    Also documents a WSL2 trap that cost real debugging time: ROS 2's
    default Fast DDS discovers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
2026-07-18 Fix both launch files (URDF parsed as YAML) + add an RViz config
    Neither launch file actually ran. robot_state_publisher's
    robot_description parameter got xacro's XML output, which launch tried
    to parse as YAML and died on:
    Unable to parse the value of parameter robot_description as yaml
    Wrapping it in ParameterValue(..., value_type=str) is the fix. My
    earlier verification missed this because `ros2 launch --show-args` only
    proves a launch file is discoverable and the headless tests ran
    fake_drive directly through `ros2 run` -- so the launch path itself was
    never exercised until RViz was opened for real.
    Also adds melvinn.rviz so RViz opens with the RobotModel and TF displays
    already con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
2026-07-18 Add masses + all components to the URDF, and a mass/torque report
    Adds every component that actually rides on the robot (Pi, power bank,
    both battery packs, PCA9685, L9110S, speakerphone, USB hub) with real
    masses, plus inertial blocks on every existing link via new inertia
    macros. mass_report.py then does forward kinematics over the tree and
    reports total mass, centre of gravity, and whether the drivetrain has
    torque margin.
    The result reproduces the bench behaviour from part specs alone:
    TOTAL 2.01 kg, CoG x+0.003 z+0.115
    rolling needs 4.8 mN-m/wheel, TT gives 7.8-11.8 -> margin x1.6-2.4
    BREAKAWAY needs 19.3 mN-m/wheel, TT gives 7.8-11.8 -> margin x0.4-0.6
    Rolling has margi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
    [inertia.xacro, melvinn.urdf.xacro]
2026-07-22 Add bts7960_test.py: standalone bring-up for the new 4WD drivers
    Two BTS7960 modules (one per side, two motors paralleled each) replacing
    the overloaded single L9110S. Reuses the freed-up L9110S GPIO (16/20 left,
    27/22 right) as the RPWM/LPWM direction pins -- gpiozero's Motor(forward,
    backward) maps straight onto them. Standalone so the wiring is proven
    before assistant.py is touched.
2026-07-22 README: consolidated Wiring reference — one table per component
    Replaces the single "Motors (L9110S)" section with a "Wiring reference"
    that documents every component's Pi connections in the same table style:
    drive (2x BTS7960), arm (PCA9685), ultrasonic (HC-SR04), face screen
    (ST7789), camera (CSI note), and USB/power. Keeps the L9110S table in a
    collapsible as the superseded setup, and the motor-return-current WiFi
    gotcha. Physical pin numbers throughout, matching pi3-pinout.png.
2026-07-23 Drive with the two BTS7960s: real 4WD, loose-wire workarounds removed
    The L9110S and its failure modes are gone, so assistant.py now drives one
    gpiozero Motor per side (left=GPIO16/20, right=GPIO27/22) straight onto each
    BTS7960's RPWM/LPWM:
    - Remove MOTOR_A_FORWARD_ONLY, _ForwardOnlyMotor, and MOTOR_A_A1A_STUCK --
    those worked around a loose A-1A jumper on hardware that no longer exists.
    backward/left are true two-side moves again, not one-wheel pivots.
    - Rename motor_a/motor_b -> motor_left/motor_right (side names match the
    boards); wheel_jog_test.py follows.
    - ROCK_START off by default: bench test confirmed the BTS7960s spin all four
    wheels fast with no heat, so breakaway jabbing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
    [assistant.py, wheel_jog_test.py]
2026-07-24 bts7960_test: wait for ENTER before each move
    Each step now runs when you press ENTER instead of on a fixed timer, so
    there is time to watch each wheel pair and note its direction before the
    next move fires. Ctrl-C still aborts (KeyboardInterrupt propagates out of
    input() into the finally that stops both sides).
    [bts7960_test.py]
2026-07-24 Add drive_forward.py: drive forward until ENTER
    Tiny floor-test helper: spins all four wheels forward on launch and stops
    on ENTER (or Ctrl-C -- the finally always stops both sides).
2026-07-24 README: note the JGA25-370 6V drive-motor upgrade in the wiring reference
    The TT motors are being replaced with 4x JGA25-370 6V 60RPM metal
    gearmotors (ordered Jul 2026). Electrically nothing changes -- same pins,
    buses, and fuse -- so the Drive table stays as-is; the note records the
    mechanical stack (25mm bracket, 4mm brass hex cople, 65mm hex wheel) and
    the expected ~0.2 m/s cruise.
2026-07-24 Give MELVINN its own voice: a Rocky-style chirp language
    melvinn_voice.py synthesizes little musical tone-sequences with SoX (a
    warm 'pluck' timbre, not harsh beeps) for MELVINN's states -- wake, yes,
    happy, found, search, working, sad, no, curious, bye. Standalone to
    audition (python3 melvinn_voice.py), importable as chirp(name). Wired
    into assistant: it perks up ('wake') when it hears its name, chirps
    while hunting ('search'), trills ('happy') when it grabs, and drops a
    sad tone when it misses. Degrades to a no-op if sox is missing.
    [assistant.py, melvinn_voice.py]
2026-07-24 Ship MELVINN's signature voice: warm base Piper + subtle SoX character
    The default 'melvinn' voice is now a consistent identity, not raw amy:
    base timbre = SIGNATURE_VOICE (joe if installed, else voice.onnx) run
    through a subtle SIGNATURE_FX (slight pitch drop + light chorus for
    warmth). Applied only to the default voice and only when no explicit
    effect is chosen, so 'add a monster effect' and named voices still work.
    Both tunable via MELVINN_SIGNATURE_VOICE / MELVINN_SIGNATURE_FX env
    vars (set FX to '' to disable).
2026-07-24 MELVINN signature voice: warmer, drop the robotic chorus
    The chorus was making it sound synthetic. New signature = bass +4
    (warmth) + treble -1 (soften highs) + reverb 12 (natural room), no
    chorus or pitch-shift.
2026-07-25 Add face_test.py: ST7789 bring-up -- color fills, then first eyes
    Drives the 2-inch IPS face screen over SPI0 (CS=CE0, DC=GPIO24, RST=GPIO25
    per the README wiring reference) with the Pimoroni st7789 lib. Fills
    R/G/B/white, then draws two eyes that look around and blink. ROTATION and
    INVERT constants up top for per-panel variation.
    [face_test.py]
2026-07-25 face_test: drop SPI to 10 MHz for Dupont-jumper reliability
    60 MHz over loose jumpers often leaves the panel uninitialized (lit
    backlight, blank image). 10 MHz is rock solid; raise it once the panel
    is proven.
    [face_test.py]
2026-07-25 Add face_probe.py: cycle ST7789 res/rotation combos to find the variant
    A lit-but-blank panel with verified wiring usually means pixels are
    landing outside the visible RAM window -- the fix is finding which
    width/height/rotation declaration this panel variant respects. The probe
    walks all six legal combos, filling RED then BLUE for each, and prints
    which config is on screen.
2026-07-25 face_probe: only rotation 0/180 exist for non-square panels
    The lib rejects 90/270 for both 240x320 and 320x240; probe the four
    legal combos.
2026-07-25 Face screen runs on an in-repo raw ST7789V driver -- the lib never could
    The Pimoroni st7789 python lib left the GMT020-02-7P panel uninitialized
    (lit backlight, blank image) through every legal config, while the bare
    datasheet sequence in st7789_raw_test.py lit it first try. So the face
    now runs on st7789_raw.py, a ~90-line driver: datasheet init, MADCTL
    rotation map, numpy RGB565 blit via writebytes2. face_test.py rewritten
    on top of it, with ROTATION/SPI_HZ/BGR knobs for panel variation.
2026-07-25 Add melvinn_hello.py: blink -> I am MELVINN -> arm wave
    First combined face+arm performance. Eyes wake up and blink on the raw
    ST7789V driver, the screen introduces MELVINN by name with a smile, then
    the arm settles at its safe center pose and waves the wrist twice
    (same PCA9685 setup and center angles as assistant.py). Face-only
    fallback when the PCA9685 is unreachable.
2026-07-25 README: face screen is wired and working -- real wiring + driver notes
    Replace the planned-pins section with what the bring-up actually
    established: the board is a GMT020-02-7P (ST7789V, 7-pin, backlight
    hardwired to VCC), VCC rides the shared 3.3V junction since both 3.3V
    pins are taken, pins listed in the header order of the board, SPI enable
    one-liner, and the hard-won warning that the Pimoroni st7789 lib never
    initializes this panel -- the in-repo raw driver (st7789_raw.py) is the
    supported path. Lists the four face scripts.
2026-07-25 MELVINN learns his face exists: set_face/show_text/screen_off/dance tools
    The Claude brain now knows about the LCD face and can use it on its own
    judgment. New in assistant.py:
    - face section on the raw ST7789 driver (lazy init like the arm):
    expression frames (happy/sad/thinking/surprised/sleepy/love/neutral/
    blink incl. heart eyes and Zz), wrapped-text display, screen sleep
    - dance_routine: rhythmic arm groove + face frames as a background
    action, stoppable with stop, composable with play_song
    - four new tools wired into TOOLS + run_tool
    - system prompt: LCD in the body description, face usage guidance, and
    the anti-roleplay rule (physical asks must call tools, neve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
2026-07-25 rickroll: play through the USB speakerphone, not the default device
    Bare mpg123 sends audio to the Pi default (HDMI/jack) which has nothing
    attached -- assistant.py already routes music with -a plughw:1,0, so do
    the same here.
2026-07-25 MELVINN plays videos on his face: download_video + play_video tools
    st7789_raw gains display_raw565() -- blits a pre-formatted RGB565
    big-endian frame straight to the panel, which is exactly what ffmpeg
    emits with -pix_fmt rgb565be, so video frames go decoder -> SPI with
    zero conversion.
    assistant.py: download_video fetches <=360p single-file formats via
    yt-dlp into ~/videos; play_video runs one ffmpeg with two outputs --
    video scaled/padded to 320x240 at 12fps on stdout (blitted raw), audio
    to the USB speakerphone over ALSA -- so A/V share a clock. Runs as a
    background action, stoppable with stop; waits 2.5s before grabbing the
    exclusive audio device so the spoken acknowledgement finishes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
2026-07-25 Docs + banner: advertise the full MELVINN command set
    The assistant docstring, startup banner, and README example-commands
    block still described the launch-day feature set (drive, one song,
    stop). All three now list the whole toolbox by category: drive, arm and
    dance, camera-guided grabbing, sensing, music, videos on the face
    screen, expressions/text on the LCD, voices and effects, test scripts,
    and the universal stop. The Claude-brain banner is a one-liner; the
    offline brain keeps the old keyword hint since that is all it parses.
2026-07-25 System prompt: tool results are the truth -- no claiming success on failure
    MELVINN announced a video was playing on his face right after the tool
    reported the face screen unavailable. Add an explicit honesty rule: when
    a tool reports failure, say what failed; never claim the action worked.
    [assistant.py]
2026-07-25 Surgical arm control: nudge_arm (relative degrees) + arm_status tools
    move_arm only takes absolute angles, which makes user-guided fine
    positioning clumsy. nudge_arm moves one joint BY a signed relative
    amount (finest step 1 degree) from its last commanded angle, clamped to
    0-180 with an at-limit message; arm_status reports every joint's
    current angle. System prompt teaches the incremental-guidance pattern
    and asks for ultra-short replies while the user is directing.
    [assistant.py]
2026-07-25 MELVINN can truly see: the see tool returns a camera photo to Claude
    robot_see() captures a frame via the existing perception camera path,
    converts BGR->RGB, JPEG-encodes at <=640x480, and returns it as an
    image content block in the tool_result -- so the vision-capable brain
    literally looks at the scene and can describe objects, read text, and
    recognise anything, far beyond look_for_object color blobs. Falls back
    to a plain string when the camera is unavailable (as it is on the dying
    SD card until the rebuild). The tool loop already passes block-list
    content through untouched, and history trimming handles image results
    like any other tool_result.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
2026-07-25 Vision-guided grab: Claude drives see -> steer -> approach -> verify
    The see tool proved itself on-device (the camera stack works after all
    -- MELVINN described a real scene on first use), but grabbing still
    routed to the colour-blob script. The system prompt now teaches a
    vision-guided loop Claude runs itself for arbitrary objects: photo,
    judge frame position, small steering turns, ultrasonic approach with
    re-centring, reach/close/lift, then a verification photo reported
    honestly. Colour-blob grab(color) stays the fast path for plain
    red/green/blue/yellow blobs. Also removes the stale cannot-reverse
    claim from the L9110S era -- the BTS7960s reverse fine, and both grab
    procedures now use bac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
    [assistant.py]
2026-07-25 Camera flip off: the remount put it right-side-up
    FLIP_180 was True in all five camera scripts for the original
    upside-down mount; after the chassis/arm rebuild the camera sits
    right-side-up, so the software flip itself was inverting the image
    (seen on the live stream). Set False everywhere: camera_stream,
    camera_test, papoi, perception (feeds the assistant see/grab), and
    vision_track.
    [camera_stream.py, camera_test.py, papoi.py, perception.py, vision_track.py]
2026-07-25 Add face_styles.py: 20-look fashion show for picking MELVINN face style
    Cycles twenty distinct face designs on the ST7789, 20 seconds each,
    looping until Ctrl-C (ends on the classic smile). Each frame carries a
    small number/name label and the terminal prints the current style:
    classic, cyclops, pixel, EVE, KITT visor, kawaii, cat, neon rings,
    matrix, hearts, stars, sleepy, angry, ghost, baymax, puppy, odd eyes,
    squircle with brows, fire, galaxy.
2026-07-25 face_styles round 2: four finalist families x seven emotions each
    Keeps the picked styles -- pixel, eve, ghost, squircle -- and gives
    every family a full emotional range (happy, neutral, sad, angry,
    surprised, sleepy, love), with the liked round-1 angry and sleepy
    designs reinterpreted as those emotions inside each family: pixel gets
    red blocks + block brows and a pixel-heart love; EVE emotes purely
    through eye shape/tilt/color; ghost adds a tear, brows and a zigzag
    mouth on white; squircle leans on eyebrow angles, red pupils with a
    gritted-teeth mouth, and heart pupils. 28 frames, 4s each, looping;
    Ctrl-C ends on squircle happy.
2026-07-26 Add melvinn_rickroll_video.py: real video + arm dance, screen cuts to party face
    Like melvinn_rickroll but plays the actual Never Gonna Give You Up video
    on the panel (same ffmpeg rgb565be pipe + ALSA audio path as the
    assistant), with the same arm groove in a thread. The screen alternates:
    ~6s of decoded video, then ~2s of a bouncing squircle-happy celebration
    face (darting pupils, big grin, blinking sparkles), back and forth.
    Sync trick: every frame is read off the pipe every loop so ffmpeg and
    audio never stall -- during a celebration window we simply blit the
    party face instead of the frame we just drained, so audio keeps flowing
    and only the display changes.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
    [melvinn_rickroll_video.py]
2026-07-26 Give MELVINN persistent memory + rename [robot] prints to [MELVINN]
    Memory (OpenClaw pattern): melvinn_memory.md is loaded into the Claude
    brain's system prompt each session (WHAT YOU REMEMBER), and a 'remember'
    tool lets MELVINN save facts itself across conversations; 'forget_memory'
    clears it. Offline brain handles 'remember ...', 'what do you remember',
    'forget everything'. SYSTEM now tells the brain it HAS memory so it stops
    claiming it can't. Also renamed the [robot] console prefix to [MELVINN].
2026-07-26 Docs: bring wiring current -- BTS7960 drive + ST7789 face screen
    HARDWARE.md and two stale references still described the L9110S robot
    from two upgrades ago and never mentioned the LCD face. Now current:
    - HARDWARE.md parts: L9110S -> 2x BTS7960 (43A, one per side), drive
    power is a 6V NiMH pack fused at 7.5A, and a new Face screen section
    for the GMT020-02-7P / ST7789V panel
    - HARDWARE.md wiring quick reference: full BTS7960 pin map (RPWM/LPWM/
    R_EN/L_EN per board, B+/B- via the fuse) replacing the L9110S table,
    plus the ST7789 SPI wiring table and the raw-driver pointer
    - README top feature bullet: Drive now BTS7960 (was L9110S), marked
    working with the metal-gear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
2026-07-26 Smart arm: vision-guided grab (controllers/arm_controller)
    New controllers/ package holds the 'where should the arm go' logic,
    separate from the brain. arm_controller: pure functions that map the
    camera's horizontal offset -> a base servo angle, so the arm swings its
    base to FACE the object's bearing instead of always reaching dead-ahead.
    smart_grab() executes it (aim -> reach -> grip -> lift -> verify, with
    chirps), falls back to the fixed reach pose if unseen. Wired as a
    smart_grab tool; smart_grab_test.py to try it. Arm-only, no wheels, safe
    with the drivetrain unplugged. Camera is chassis-fixed so this is
    vision-guided aiming, not eye-in-hand servoing -- IK/servoing grow here
    later. Tuni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
    [assistant.py, smart_grab_test.py]
2026-07-26 Teach the brain closed-loop reaching: it flies the arm degree-by-degree
    Adds a REACHING strategy to SYSTEM so the Claude brain drives each servo
    itself in a see -> nudge_arm -> see -> correct loop, instead of replaying
    a fixed pose. The primitives already existed (nudge_arm/move_arm/see/
    arm_status); this instructs the brain to use them as a closed vision loop
    so 'reach for the cup' becomes the brain genuinely flying the arm by eye.
    [assistant.py]
2026-07-26 Stop MELVINN faking grabs: hard honesty rule in the brain prompt
    It was claiming 'got it / lifted' when the object never moved (it can't
    see its own gripper, so Claude Vision confabulated success). Now the
    prompt forbids claiming a grab from assumption -- it must verify the
    object actually LEFT its spot, or admit it can't confirm and ask the
    user. A false 'got it' is worse than an honest miss.
2026-07-26 Teach the brain to use ALL the arm's joints when reaching
    It was only nudging base+shoulder and hovering short. SYSTEM now spells
    out what each of the 6 joints does (base aim, shoulder height, elbow
    distance, wrist gripper-angle, wrist_rotate, gripper) and calls out the
    common mistake, telling it to start from arm_pose('reach') then
    coordinate shoulder+elbow+wrist together to actually land on the object.
    [assistant.py]
2026-07-26 Smoother arm: nudge_arm now glides and caps a single move at 20 degrees
    nudge_arm was setting the servo angle directly = an abrupt snap, and had
    no size limit. Now it eases to the target via robot_move_arm(smooth=True)
    and clamps any requested move to +/-20 deg (MAX_NUDGE), so the brain's
    degree-by-degree reaching moves gently instead of jerking.
    [assistant.py]
2026-07-26 smart_grab keeps trying (6x, adapting) + is stoppable; steer brain to it
    Answers 'why one run then stops' + 'let me say stop':
    - smart_grab now retries up to 6 times, reaching a bit lower/further each
    attempt so it doesn't repeat the same miss, and every attempt checks
    _stopped() so 'stop' interrupts it (it's a background action).
    - SYSTEM tells the brain: the inline degree-by-degree reach is ONE
    attempt and can't be interrupted (turn blocks); for keep-trying,
    stoppable grabs, call smart_grab instead.
    [assistant.py]
2026-07-26 Smoother arm: coordinated multi-joint motion with ease-in/out
    Poses previously moved one joint at a time (base finishes, then
    shoulder, then elbow...), which reads as robotic. Add move_joints(): all
    joints interpolate together over one shared duration with a raised-cosine
    ease-in/ease-out, so the arm flows to a pose as a single fluid motion
    that accelerates and decelerates smoothly. arm_pose now routes through
    it (so grabs, hello, dance all benefit). New move_arm_smooth tool +
    system-prompt guidance lets the Claude brain pose several joints in one
    gliding call instead of firing separate jerky move_arm calls. Single-
    joint nudge_arm/robot_move_arm smoothing is unchanged.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
2026-07-26 Arm control: fly it by hand servo-by-servo, not canned poses
    The brain was steered to start every reach from arm_pose(reach) and
    fine-tune -- i.e. lean on a predefined posture. Reframe the reaching
    guidance around manual degree-by-degree control: a tight
    arm_status -> see -> move ONE servo a few degrees -> look again ->
    correct loop, walking each joint (base aim, shoulder height, elbow
    distance, wrist tilt) toward the goal one at a time, no canned pose.
    move_arm_smooth is now scoped to expressive gestures only (not
    reaching), and smart_grab is demoted to an opt-in hands-off macro rather
    than the default -- flying it by hand is the default when the user wants
    smart arm control. Honesty rules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
    [assistant.py]
2026-07-27 Arm reach: visually servo the gripper, and dont stop short / claim early
    On-device the gripper turns out to be VISIBLE in the chassis camera frame
    when the arm is extended, so the brain can servo visually after all.
    Correct the old cannot-see-gripper assumption: when both gripper and
    object are in the photo, judge the gap between them and keep nudging
    (elbow/shoulder/wrist) to close it, falling back to arm_status only when
    the hand is out of frame. Add an explicit dont-stop-short rule -- a few
    cm of visible gap is NOT there yet; never say in position / perfect /
    ready to grip while space remains, and drive forward 0.2s if the arm is
    maxed and still short. Fixes MELVINN declaring a reach done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
    [assistant.py]
2026-07-27 Arm reach: fix the monocular depth illusion (2D overlap != contact)
    MELVINN kept declaring the gripper on the bottle because the two
    overlapped in the single-camera image -- but one fixed camera has no
    depth, so overlap only means left/right + up/down alignment, not
    touching. Rewrite the reach guidance: never infer contact from image
    overlap; use distance_ahead (ultrasonic) and look_for_object apparent
    size for distance; drive the whole robot forward until the object is
    within the arm reach (~15-20 cm) BEFORE fine-positioning; camera for
    direction, ultrasonic for distance; only claim contact when it is both
    lined up AND close. Replaces the earlier gap-in-photo servoing text that
    was itself f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
    [assistant.py]
2026-07-27 MELVINN default face: glowing cyan dot-matrix grid eyes on a dark panel
    Redefine the signature face to match the chosen look -- two rounded
    dot-matrix eyes that glow brighter toward a movable core (the gaze), on
    a near-black panel. _grid_eye() renders the LED-matrix eye; _face_frame
    keeps its expression params (openness, gaze, tilt, tint, brows, optional
    mouth) so every caller still works, but the grid eyes are now the
    identity. Expressions retuned for the new eyes and an angry face added
    (warm-orange squint + angled brows); set_face enum and the brain prompt
    updated to include angry.
2026-07-27 download_video: cap duration/size + try player clients (fix huge DLs and 403s)
    Two on-device failures: a 1.6GB multi-hour compilation timed out (only
    resolution was capped, not length or size), and a fresh attempt hit HTTP
    403 from the android_vr fallback client when no JS runtime is present.
    Now: --match-filter duration<240, --max-filesize 60M, ytsearch5 so the
    filter can skip long comps and still find a hit, and try player_client
    web->android->tv in turn. On a 403/JS error, tell the user the exact
    yt-dlp upgrade command instead of a generic failure.
    [assistant.py]
2026-07-27 Media playback: stop/quit kill it cleanly, no hang, no audio-device fight
    Playing a video left ffmpeg untracked: quit orphaned it (kept holding the
    audio device + screen = the hang), and speak() blocked on the busy device
    with aplay errors while media played. Fix: track the video ffmpeg in a
    global _video_proc; add _stop_media() (kills music + video) and
    _media_playing(); stop and quit now call _stop_media() so playback ends
    immediately and nothing is orphaned; the finally does the same; and
    speak() shows text but skips the voice while media holds the device
    instead of hanging on it.
    [assistant.py]
2026-07-27 MELVINN can control its own volume: set_volume tool via amixer
    Adds set_volume(percent=0-100 | change=up/down), driven by amixer on the
    USB speaker card (parsed from AUDIO_DEVICE = plughw:1,0). The playback
    control name varies by device, so it auto-detects via amixer scontrols
    (Speaker/PCM/Master/... fallbacks). Wired as a set_volume tool and taught
    in the brain prompt so MELVINN stops claiming it has no volume control --
    handles turn it up, quieter, set volume to 50, too loud, etc.
2026-07-27 TTS temp WAVs to RAM (/dev/shm) -- fixes garbled radio-interference speech
    Intermittent creepypasta/radio-static speech was the TTS temp WAVs being
    written and read back through the corrupting SD card. Route all six audio
    temp files (piper/espeak/sherpa/kokoro/sox) to /dev/shm (RAM tmpfs) via a
    new _AUDIO_TMP dir, so speech never touches the flaky flash -- also
    faster. Falls back to the default temp dir if /dev/shm is unavailable.
    [assistant.py]
2026-07-27 Never block the input prompt on speech; stop media/ack audio collisions
    Typing froze during video because the conversational reply was spoken on
    the MAIN thread (blocking) and the videos ffmpeg grabbed the audio device
    mid-sentence, hanging aplay -> the input loop never returned.
    Fixes:
    - speak(background=True): the main reply now speaks in a daemon thread via
    _say(), so a long reply (or one colliding with media) never blocks input.
    - _media_pending flag: set when a video is queued (covers its 2.5s startup
    before ffmpeg is up), treated as playing so the spoken ack is text-only
    instead of colliding with the device it is about to take; cleared when
    the video ends or on stop/quit.
    - ap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
    [assistant.py]
2026-07-27 Video: lighten CPU so the terminal stays responsive during playback
    Typing was crawling during video not because of blocking code but because
    H.264 decode + per-frame SPI blit pegs the Pi 3A+, starving the (SSH)
    terminal. Reduce load: VIDEO_FPS 12 -> 8, run ffmpeg at nice -n 15 and
    cap it to 2 threads so the interactive shell and main thread keep CPU.
2026-07-27 Video plays in a separate process so the terminal never freezes
    Root cause of "can't type during video" was architectural: the decode +
    per-frame SPI blit ran as a THREAD inside the assistant, fighting the
    input loop for the Python interpreter -- fps/nice tuning could not fix
    that. Move playback to a standalone video_play.py process: play_video now
    releases the LCD (new _release_face), launches the child (tracked in
    _video_proc, niced, audio+screen owned entirely by it), and returns
    immediately. The assistant loop is completely untouched -> typing stays
    responsive. _ensure_face defers while the child owns the panel; stop/quit
    SIGTERM the child (it cleans up ffmpeg); the face re-inits lazily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
    [assistant.py, video_play.py]
2026-07-27 Video: run the whole player process at nice -n 15, not just its ffmpeg
    Even as a separate process the video (python SPI blit + ffmpeg) can peg
    the Pi 3A+ and lag the interactive SSH session at the OS level. Nice the
    entire video_play.py child, so the shell and assistant keep CPU
    priority; smooth-terminal beats smooth-video on this hardware.
2026-07-27 THE fix: ffmpeg -nostdin so it stops stealing the keyboard
    Real root cause of "can't type while media plays" -- present across every
    version I tried -- was that ffmpeg reads the terminal stdin by default
    (for interactive q/keypress control) and consumed the keystrokes meant
    for the assistant input() prompt. Not threads, not CPU, not the SD card.
    Add -nostdin + stdin=DEVNULL to the video ffmpeg, and stdin=DEVNULL to
    the mpg123 music player for the same reason. This is why Ctrl-C worked
    (a signal, not stdin) but typing stop never did.
    [assistant.py, video_play.py]
2026-07-27 Fix Claude brain history poisoning: guarantee tool_result + self-heal
    A tool that raised mid-loop left its assistant tool_use block in history
    with no matching tool_result -> every subsequent request 400d
    ("tool_use ids were found without tool_result blocks") -> MELVINN fell
    back to offline mode permanently. Two fixes: wrap run_tool so every
    tool_use ALWAYS gets a tool_result (errors become the result text), and
    catch a tool_use/tool_result mismatch in claude_brain to reset the
    history to the current turn and retry once, so a single bad turn can no
    longer poison the whole session.
    [assistant.py]
2026-07-28 setup.sh: install the Claude brain + face-screen deps, enable SPI
    A fresh-card rebuild left the smart brain and LCD face non-functional
    until manually pip-installed. Add anthropic (Claude brain), spidev +
    Pillow (ST7789 face; numpy already comes via opencv) to the pip step,
    enable SPI via raspi-config, and add an API-key reminder to the
    completion message so a rebuild comes up fully capable.
2026-07-29 setup.sh: just add the anthropic brain dep (LCD already handled)
    Narrow the earlier change to what was actually missing: the anthropic
    package for the Claude brain. Drop the spidev/Pillow install and the SPI
    enable -- the LCD face already works via the existing setup path. Keep
    the API-key reminder in the completion message.
2026-08-02 Drive: flip LEFT motor direction to match RIGHT (new drivetrain wiring)
    With the JGA25 motors installed, the LEFT side ran inverted -- LEFT
    forward drove the wheels backward while RIGHT was correct, so the robot
    would spin instead of driving straight. Swap the left Motor pins
    (forward=20, backward=16) in assistant.py, bts7960_test.py, and
    drive_forward.py so all four wheels agree on forward.
    [assistant.py, bts7960_test.py, drive_forward.py]
2026-08-02 Drive: flip the RIGHT side instead of the left (per on-robot check)
    Reverts the previous left-side flip. Left restored to forward=16/
    backward=20; right flipped to forward=22/backward=27 so all four wheels
    agree on forward, matching what the robot actually does on the floor.
    [assistant.py, bts7960_test.py, drive_forward.py]
2026-08-02 Drive: revert to original pin mapping (left 16/20, right 27/22)
    With a charged battery the direction test read cleanly: LEFT correct,
    only RIGHT reversed. Undo the earlier right-side flip so right returns
    to forward=27/backward=22 -- back to the original mapping where both
    sides agree on forward. (The low battery had muddied the earlier
    observations that prompted the flips.)
    [assistant.py, bts7960_test.py, drive_forward.py]
2026-08-02 Add drive_jog.py: live RC-style keyboard driving of the wheels
    Companion to arm_jog_test.py for the drivetrain. WASD / arrow keys drive
    MELVINN continuously (motors hold state between keypresses, so one tap
    rolls until you steer or stop): forward/back, pivot left/right, space to
    stop, q to quit. Reuses the same left/right BTS7960 motor objects the
    assistant drives. wheel_jog_test.py stays as the per-motor direction
    diagnostic; this is the drive-it-around tool.
2026-08-02 Remove obsolete face_probe.py (used the abandoned Pimoroni st7789 lib)
    face_probe.py was a throwaway diagnostic from figuring out the panel --
    it imports the Pimoroni st7789 library, which we deliberately dropped
    because it never initialised the GMT020-02-7P. The working face scripts
    (face_test.py, face_styles.py, the assistant face) all use the in-repo
    raw driver st7789_raw.py. Running the probe only ever raised
    ModuleNotFoundError; delete it so it stops confusing.
2026-08-02 Docs: JGA25 metal gearmotors are INSTALLED (were in progress/ordered)
    The metal-gear drivetrain upgrade landed and works, so flip the three
    places that still said in-progress/ordered to installed: README drive
    bullet, README drive-upgrade note, HARDWARE parts note. Add the
    practical caveat learned on-device -- the JGA25s draw more current than
    the TTs, so a sagging battery makes the drive crawl/veer (check the
    battery first), and the 7.5A fuse may need bumping to 10A on carpet
    starts.
2026-08-02 ROS model: JGA25 masses + torque, retire L9110S/TT references
    URDF now models the installed drivetrain: wheel_mass 0.065 -> 0.135 kg
    (65mm wheel + JGA25 gearmotor), the driver payload renamed l9110s ->
    drivers at 2x BTS7960 mass (0.066 kg), and the mass/intro comments
    updated. mass_report.py uses JGA25 stall torque (2-5 kg-cm) instead of
    the TT figures and its narrative reflects that the robot now has
    breakaway margin. ros2/README reframes the why-he-barely-moves section
    as the historical TT diagnosis + the JGA25 fix. No l9110/TT_STALL refs
    remain.
    [melvinn.urdf.xacro]
2026-08-02 Redraw wiring-overview.svg for the current build
    Replace the old L9110S + 2 DC motors + AA-battery diagram with the
    present setup: Raspberry Pi driving 2x BTS7960 (Left/Right, with the
    GPIO pin labels) into 4x JGA25 gearmotors (left/right paralleled pairs),
    a 6V NiMH drive pack fused at 7.5A with shared B+/B-, the PCA9685 + arm
    on its own servo NiMH, the HC-SR04, and the new ST7789 LCD face on SPI0.
    Adds a display (SPI) legend entry.
2026-08-02 feat(perform): full-body song performance (melvinn_performs.py)
    Recreates the RoboThespians' "I Am Not A Robot" performance on MELVINN's
    body -- one arm + wheels + LCD face instead of a humanoid. Reuses the real
    assistant functions so it behaves like the voice commands:
    music play the track (auto-downloads to ~/music once)
    face grid-eyes emote through verse/chorus (set_face)
    text flash "I'M NOT A ROBOT" on the panel (show_text)
    arm coordinated ease-in/out sways, nods, reaches (move_joints)
    gripper "claps" as hands on the beat
    wheels forward/back rocks + a chorus spin (--no-drive to disable)
    voice spoken robot-effect intro & outro
    Honors the exclusive ALSA devic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
2026-08-03 feat(perform): use the robots'-video audio + bigger arm, varied wheels
    The performance was playing the Marina STUDIO mp3. Extract the audio from
    the actual RoboThespians clip (youtube CycD3e7UaDM) to a dedicated file
    ~/music/robothespians_not_a_robot.mp3 and play THAT, so it's the version
    from the video, not the studio track.
    Also address the "arm barely moves / wheels always the same" feedback:
    arm - big shoulder/elbow poses (up, reach, bow, high), fist pumps,
    wrist waves, base sweeps; every beat clearly moves the arm
    wheels - randomized pool (rock, wiggle, spin L/R, quarter-turn, hold)
    instead of the same rock+spin each chorus
    Faces kept as-is (grid-eyes emote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
2026-08-03 fix(arm): move PCA9685 to software i2c-gpio bus 3 (hardware bus damaged)
    The Pi's hardware I2C (bus 1, GPIO2/3) was damaged when the PCA9685 servo
    power (V+, ~6V) was accidentally wired to SCL (GPIO3). The board tested
    healthy on an Arduino (0x40 + 0x70), so the failure is the Pi's bus.
    Fix: relocate the PCA9685 to a bit-banged software i2c-gpio bus on the
    unused GPIO4 (SDA) / GPIO23 (SCL), enabled via:
    dtoverlay=i2c-gpio,bus=3,i2c_gpio_sda=4,i2c_gpio_scl=23
    Code: open the bus with adafruit_extended_bus.ExtendedI2C(N) instead of
    Blinka's hardware-only busio.I2C(board.SCL, board.SDA). Default bus is 3,
    overridable with MELVINN_I2C_BUS (set to 1 for a repaired/replacement Pi).
    Applied to _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
    [assistant.py, melvinn_hello.py, melvinn_rickroll.py, melvinn_rickroll_video.py]
2026-08-03 fix(arm): correct pip package name to adafruit-extended-bus
    The extended-bus dep was named adafruit-circuitpython-extended-bus, which
    doesn't exist on PyPI (pip: "No matching distribution found"). The real
    package is `adafruit-extended-bus` (v1.0.2); the import stays
    `adafruit_extended_bus`. Fixed the setup.sh install line and the code note.
    [assistant.py]
2026-08-04 polish(perform): keep the arm high so it clears the camera + case
    The arm was dipping onto MELVINN's front and hitting the camera/case: the
    "reach" (shoulder 105), "bow" (shoulder 115, wrist 55 pointing down) and the
    pump's 120 low point all folded the arm forward/down.
    Floor the shoulder at MIN_SHOULDER (155) and get the big, varied movement
    from SAFE joints instead — horizontal base sweeps, wrist waves, wrist twists,
    gripper claps, and high shoulder pumps (176<->158). New pose set (up/tall/
    left/right/outL/outR) all stay >=158. Documented MIN_SHOULDER so it's easy to
    raise if it still grazes anything.
2026-08-04 polish(perform): raise the arm higher (still fouling the front)
    Arm was still too low at the 155-160 floor. Lift MIN_SHOULDER 155 -> 168 and
    raise every pose to 168-178 (near-vertical; 180 = straight up), tuck the elbow
    a touch (52-72) so the forearm reaches forward less, and lift the pump low
    point 158 -> 168. Shoulder now leans at most ~12 deg off vertical.
    [melvinn_performs.py]
2026-08-04 polish(perform): raise arm again — near-vertical (MIN_SHOULDER 168 -> 174)
    Almost clear at 168; nudge higher. Floor 168 -> 174, poses 174-179, elbow
    tucked further (50-68), pump low point 168 -> 174. Arm now leans only ~6 deg
    off straight-up.
2026-08-04 feat(perform): lively LCD — background face thread, way more on screen
    Before, the face changed once per beat and sat static while the arm moved.
    Now the LCD gets its own daemon thread so it's ALWAYS busy for the whole
    song, independent of the arm's timing:
    - 8 expressions (added angry/sad/sleepy) instead of 5
    - flashing text cycles 12 phrases (not just "I'M NOT A ROBOT")
    - blinks, darting eyes (pupil offsets), head-tilt bobs, heart-eyes flashes
    Face is SPI, arm is I2C, wheels are GPIO — separate buses, no collision. The
    main loop now only drives arm + wheels and never touches the screen; the
    thread is started after the intro and joined before the outro/finale.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
    [melvinn_performs.py]
2026-08-04 feat(perform): near-vertical arm + 8 screen animations
    Arm: raise MIN_SHOULDER 174 -> 178, poses 178-180 (basically straight up),
    elbow tucked (48-62) and wrist pulled in so the forearm doesn't reach forward
    either. Base spin + wrist/twist carry the dance now.
    Screen: add multi-frame animations to the face thread -- look-around, eye-roll
    (full circle), openness pulse, head-shake wobble, disco colour flash, double
    blink, heart-eyes, and zzz. _face_show now streams expressions + text +
    random animations at a faster cadence. Swapped EYE_DARTS for a COLORS palette;
    added `import math` for the eye-roll.
    [melvinn_performs.py]
2026-08-04 polish(perform): pin shoulder straight up (180) + tuck elbow to its centre
    Shoulder is now pinned at 180 (physical max — can't go higher in software).
    The leftover "low" look was the ELBOW swinging the forearm out/down, so all
    poses drop to elbow 45-48 (its chassis-clearing centre), keeping the forearm
    folded up. a_pump is now a horizontal base bounce (no vertical dip) and a_wave
    stays near level. If it still reads low, that's the arm's mounting/elbow zero,
    not the pose angles.
2026-08-04 feat(perform): 21 emotional face styles + 5 emotion animations
    More faces, more feeling. Replace the 8-expression list with an EMOTIONS
    table of 21 styles built from _face_frame params (openness, gaze, tilt,
    brows, mouth, colour, hearts): excited, joyful, smitten, shocked, furious,
    worried, suspicious, mischief, cool, playful, sassy, proud, bored, ... each
    with its own colour/brow/mouth. Add 5 emotion animations — laugh (bouncing
    grin), cry (teary blue wobble), rage (red shaking scowl), swoon (heart-eye
    sway), shock (eyes pop wide) — bringing the anim set to 13. More text flashes
    too. _face_show streams faces + text + animations continuously.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
    [melvinn_performs.py]
2026-08-06 fix(obstacle): drop stale rock-start (the cause was a low battery)
    obstacle_avoid.py was already on the new BTS7960 pins (16/20/27/22), but it
    still jabbed the motors (ROCK_START, 3x3 rounds) on every start-from-stop to
    "break static friction". That sluggish cold start turned out to be a LOW
    BATTERY, not friction — on a charged pack the robot starts fine, and
    assistant.py already runs with ROCK_START=False. Remove the rock-start
    constants + logic; drive_forward/turn_right now drive directly.
    [obstacle_avoid.py]
2026-08-06 feat(cad): parametric two-level 3D-printable chassis (OpenSCAD)
    cad/melvinn_chassis.scad — one parametric file, many parts via `part=`:
    lower deck (Pi + 2x BTS7960 + PCA9685, power bank strapped under the belly),
    upper tier / second level (arm at the front + USB mic/speaker + both NiMH
    packs strapped over the 60mm gap), a walled tray, a front face plate (LCD
    window + HC-SR04 holes), an assembly preview, and split deck halves for
    small print beds. Every component footprint/hole-spacing is a labeled
    variable; only the Pi hole pattern is exact, the rest tagged // MEASURE.
    [melvinn_chassis.scad]
2026-08-06 tweak(obstacle): stop distance 25cm -> 50cm
2026-08-07 feat(perform): Oliver Tree "Cash Machine" + reusable engine + vertical arm
    - Parameterize melvinn_performs.perform(source, song_path, intro, outro,
    texts); the song, spoken bookends, and LCD text are now arguments. Defaults
    keep "I Am Not A Robot". ensure_audio() takes any yt-dlp source (URL or
    "ytsearch1:<query>") and a deterministic path.
    - New melvinn_cash_machine.py: a thin wrapper reusing the whole engine, fetches
    the Oliver Tree track by search, money-themed intro/outro + LCD text.
    - Arm is now STRICTLY VERTICAL: the arm base sits on the second tier beside the
    mic + batteries, so every pose keeps shoulder=180/elbow=45/wrist=90 and moves
    ONLY the base (rotate) + wrist_rotate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
2026-08-07 feat(perform): picture animations on the LCD (moon, witch, ghost, bat, spell)
    Add 6 scene animations that draw ICONS straight to the panel with PIL (not the
    grid-eye face): crescent moon + twinkling stars, a witch flying across the moon
    on her broom, a bobbing ghost, a bat flapping across a moon, a lightning/spell
    zap, and a twinkling starfield. They run in the same face thread and check
    stop/music between frames. Added to the shared ANIMS, so every show gets them
    (fits the Gruntilda witch theme especially). Verified the drawing off-device.
2026-08-07 feat(perform): per-song animations + money set for Cash Machine
    Engine: perform(..., extra_anims=[...]) appends a song's own picture
    animations to the shared pool for that show (via a module global the LCD
    thread reads, like SCREEN_TEXTS).
    Cash Machine: adds MONEY_ANIMS — a big pulsing green $, gold coins raining
    down, a tied money bag, and dollar bills fluttering down — drawn with the
    shared _canvas/_nap/_music_alive helpers. Verified the drawing off-device.
2026-08-07 feat(perform): pixel-art Oliver Tree animation for Cash Machine
    Add a scaled-up pixel sprite of Oliver Tree (bowl cut + big mustache + baggy
    hoodie) that bops across the LCD, drawn from a 14x16 character map with a 1px
    grid gap so it reads as distinct pixels on the dot-matrix panel. Added to the
    Cash Machine extra_anims alongside the money scenes. Verified off-device.
2026-08-07 feat(perform): Oliver Tree pixel sprite -> full "Turbo" look
    Upsize the sprite to 16x21 and add his iconic Turbo details: framed amber
    tinted GLASSES, the bowl cut, big mustache, and a loud color-blocked
    windbreaker (teal + magenta block + white shoulder accents) instead of the
    plain hoodie. Render at px=10. Verified off-device.
2026-08-07 polish(perform): Oliver sprite matched to the album cover
    Redraw from the reference: bigger rounded AUBURN bowl cut with a darker
    fringe underside and shaved-undercut sides, RED wraparound glasses with BLUE
    tinted lenses (was black/amber), pouty frown instead of the mustache, and
    the purple windbreaker with pink chest panel + yellow collar. 18x22 sprite.
2026-08-07 feat(assistant): shows, any-song performances, animations + moods by voice
    Four upgrades wiring the performance work into the assistant:
    - SHOWS by voice: robot show / cash machine / gruntilda added to the SCRIPTS
    whitelist ("perform cash machine" works in both brains). run_script's body
    extracted into _run_child, which now also frees the ALSA device before
    launching (the shows play music).
    - perform_song tool: "perform Uptown Funk" -> melvinn_performs.py --song
    QUERY as a child process; the show fetches any track by search (slugged
    mp3 in ~/music) and runs the generic performance. 'stop' kills it.
    - play_animation tool: runs any of the 23 named LCD animations (witch, moon,
    ghos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
2026-08-08 camera_stream: print the real clickable link (IP + hostname), not a placeholder
    Auto-detects the Pi's LAN IP (throwaway UDP socket, no internet needed)
    and prints both http://<ip>:8000 and http://<hostname>.local:8000 so
    you can just click/copy instead of hunting for the IP.
2026-08-08 feat(cad): full-robot preview part (part="robot")
    Add a visual-only robot() module on top of the assembly: 65mm wheels with
    hubs outboard of the deck, the arm in its safe pose (vertical upper arm,
    folded elbow, wrist + gripper fingers) on the tier mount, silver HC-SR04
    cans through the face plate, and the LCD as a dark panel with two cyan
    grid eyes. Rendered with OpenSCAD (now installed on the dev PC).
    [melvinn_chassis.scad]
2026-08-08 feat(cad): place EVERY element + fix sonar/LCD collision on the face
    Complete the placement so the whole BOM has a designed home:
    - IMX219 camera: lens hole (d10) + M2 mount pattern (12.5 x 21) beside the
    LCD on the face plate (can't sit between the sonar cans — the HC-SR04
    board occupies the panel behind that strip). Lens shown in the robot
    preview too.
    - USB hub: strap slots front-centre of the lower deck (rides in the
    deck-to-tier gap; the Pico velcros to it).
    - 7.5A inline fuse: zip-tie slots where B+ runs between the BTS7960s.
    - Echo divider resistors: documented as inline-harness (no mount needed).
    - Header now lists where every element lives.
    Fix: the HC-SR04 holes (span 41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
    [melvinn_chassis.scad]
2026-08-09 feat(perform): Oliver Tree "Alien Boy" show + alien animation set
    New melvinn_alien_boy.py on the melvinn_performs engine, with its own
    extra_anims: a UFO flyby (saucer, dome, blinking belly lights over stars),
    a pixel alien head that bobs and blinks, a ringed planet drift, and the
    showpiece — the UFO abducting pixel-art Oliver in its tractor beam (sprite
    reused from melvinn_cash_machine). Space-themed intro/outro + LCD text.
    Assistant wiring: "alien boy" added to the SCRIPTS whitelist (voice:
    "perform alien boy"), the 4 new animations added to ANIMATIONS and the
    play_anim.py registry (sync check: 27 = 27). Drawing verified off-device.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
    [assistant.py, melvinn_alien_boy.py, play_anim.py]
2026-08-10 fix(cad): match the real motor bracket — 2x2 slotted base pattern
    The bought bracket (Pololu-25D-style L "Duinar" clone, MercadoLibre
    2026-07-24) has a 2x2 base-hole pattern, not the 2 holes previously guessed.
    Deck now cuts 4 SLOTS per bracket (7 mm long along the axle) so a few mm of
    clone-vs-spec drift still bolts on; pattern centre sits bracket_inset=6
    inboard of the axle line to keep the outer row on the deck. Spacings
    bracket_bolt_dx/dy remain // MEASURE.
    [melvinn_chassis.scad]
2026-08-10 fix(cad): move tier posts to the deck corners, away from the wheel brackets
    The tier-post holes (+/-72, +/-48) sat ~5 mm from the motor-bracket slot
    zone — a bracket flange and a post screw would fight for the same spot.
    Posts now nestle in the deck's rounded corners (+/-90, +/-66), fully clear
    of the bracket zone (x 53-77, y 53-71), the boards, and the hub/fuse slots;
    the Pi nudged -52 -> -48 in x to keep clearance from the rear-left post.
    Tier-side screw holes follow automatically (same variables).
    [melvinn_chassis.scad]
2026-08-10 fix(cad): flat arm mount — the rigid-support base plate bolts straight down
    The arm kit's own base (confirmed from the kit photos) is the flat rigid
    support plate with the base-servo bracket on top — no turntable bearing, no
    raised feet. Replace the tier's 4 raised standoffs with a FLAT pad: 4 bolt
    slots (10 mm, around a 32x32 square // MEASURE) surrounding the existing
    cable pass-through, so bolts drop through the plate's hole grid wherever it
    lands. Ghost box in the assembly follows arm_foot.
    [melvinn_chassis.scad]
2026-08-10 polish(cad): arm sits directly on the flat mount in the robot preview
    [melvinn_chassis.scad]
